eSpark-Backup/noelmcdermott-dbsdesign-hw/Design-Files/DBS-Stepper-Module/Queries/Q-1-1.png

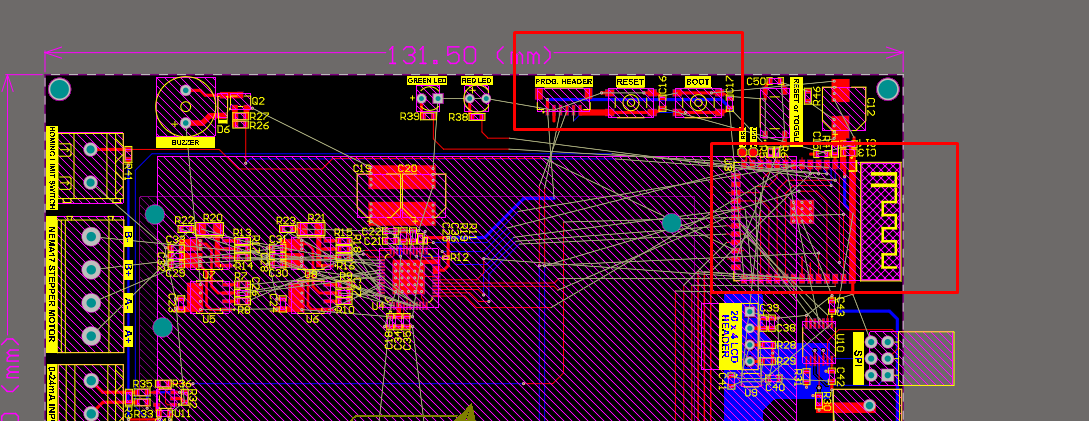
Design-Files/DBS-Stepper-Module/Queries/Q-1-1.png
