eSpark-Backup/noelmcdermott-dbsdesign-hw/Design-Files/DBS-Stepper-Module/Renderings/3D_Top.PNG

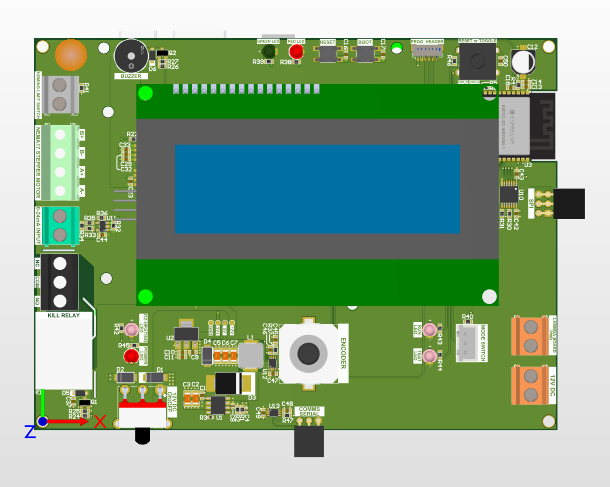
Design-Files/DBS-Stepper-Module/Renderings/3D_Top.PNG
