eSpark-Backup/noelmcdermott-dbsdesign-hw/README.md

# noelmcdermott-dbsdesign-hw
DBS Stepper Control Module

The goal is to drive a Nema17 stepper motor in either direction to a position proportional to a continuously varying 4-24 mA external input or an encoder generated input to a microcontroller. The stepper drives a linear ball screw with a 2mm pitch and “homes” to a limit switch on startup.
