eSpark-Backup/noelmcdermott-dbsdesign-hw/Design-Files/DBS-Stepper-Module/Queries/Q2.png

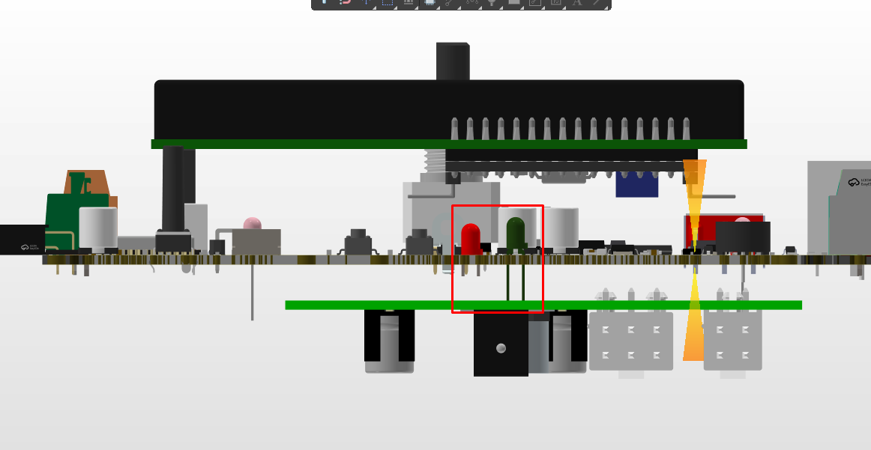
Design-Files/DBS-Stepper-Module/Queries/Q2.png
