eSpark-Backup/noelmcdermott-dbsdesign-hw/Design-Files/DBS-Stepper-Module/Renderings/2D_C_View.PNG

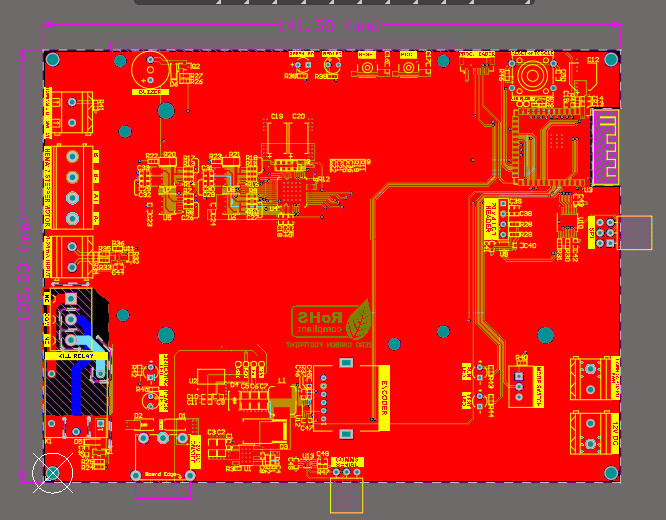
Design-Files/DBS-Stepper-Module/Renderings/2D_C_View.PNG
