eSpark-Backup/noelmcdermott-dbsdesign-hw/Design-Files/DBS-Stepper-Module/Renderings/2D_Top_Layer.PNG

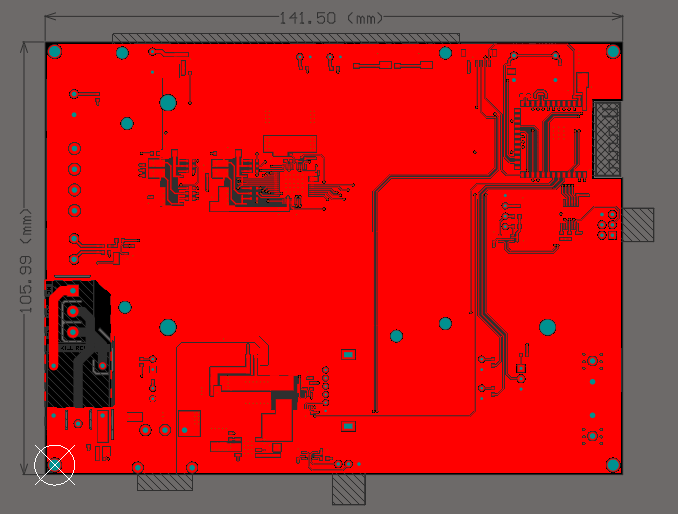
Design-Files/DBS-Stepper-Module/Renderings/2D_Top_Layer.PNG
