eSpark-Backup/noelmcdermott-dbsdesign-hw/Design-Files/DBS-Stepper-Module/Renderings/3D_Back_Edge.PNG

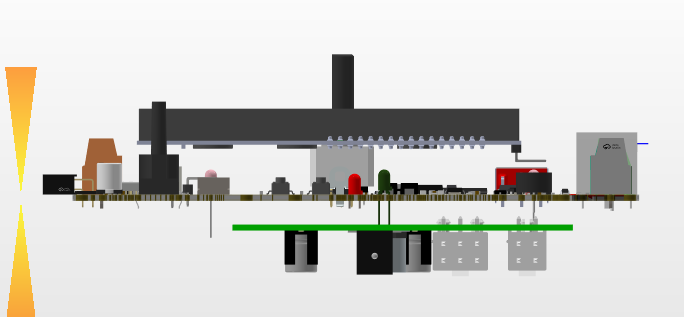
Design-Files/DBS-Stepper-Module/Renderings/3D_Back_Edge.PNG
