eSpark-Backup/noelmcdermott-dbsdesign-hw/Design-Files/DBS-Stepper-Module/Renderings/3D_Combine_View.jpeg

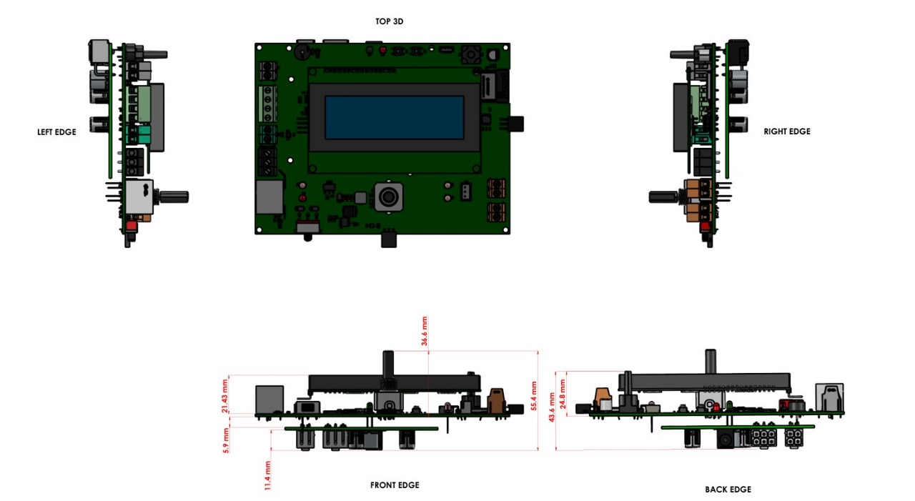
Design-Files/DBS-Stepper-Module/Renderings/3D_Combine_View.jpeg
