eSpark-Backup/noelmcdermott-dbsdesign-hw/Design-Files/DBS-Stepper-Module/Renderings/3D_Isometric.PNG

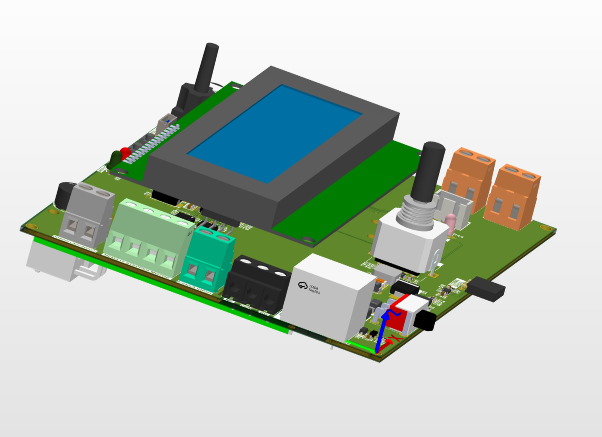
Design-Files/DBS-Stepper-Module/Renderings/3D_Isometric.PNG
