eSpark-Backup/noelmcdermott-dbsdesign-hw/Design-Files/DBS-Stepper-Module/BOM/Client BOM-v1.0.xlsx

# | Item Type | Designator | Description | Footprint | Manufacturer Part Number | Manufacturer | Value | Quantity | Client Ordered Quantity | Link | Remarks
1 | Capacitor | C1, C14, C16, C17, C18, C21, C22, C37, C39, C40, C41, C42, C43, C44, C45, C46, C47, C48, C49, C50 | CAP CER 0.1UF 50V X5R 0603 | Cap-0603 | CC0603KRX5R9BB104 | Yageo | 100nF | 20 | 22
2 | Capacitors | C2, C3 | CAP CER 10UF 50V X5R 1206 | Cap-1206 | CC1206KKX5R9BB106 | Yageo | 10uF | 2 | 4
3 | Capacitors | C4 | CAP CER 390PF 50V C0G 0402 | Cap-0402 | CGA2B2C0G1H391J050BA | TDK | 390pF | 1 | 3
4 | Capacitor | C5, C6, C7 | CAP CER 47UF 25V X5R 1206 | Cap-1206 | GRM31CR61E476ME44L | Murata | 47uF | 3 | 5
5 | Capacitor | C8 | CAP CER 0.047UF 50V X7R 0402 | Cap-0402 | CC0402KRX7R9BB473 | Yageo | 47nF | 1 | 3
6 | Capacitor | C9, C10, C15 | CAP CER 1UF 50V X5R 0603 | Cap-0603 | CL10A105KB8NNNC | Samsung | 1uF | 3 | 5
7 | Capacitor | C11 | CAP CER 4.7UF 16V X5R 0603 | Cap-0603 | CC0603KRX5R7BB475 | Yageo | 4.7uF | 1 | 3
8 | Capacitor | C12 | 47uF 50V 66mA@120Hz ±20% SMD,D6.3xL7.7mm Aluminum Electrolytic Capacitors - SMD ROHS | Custom | RVT1H470M0607 | ROQANG | 47uF | 1 | 3
9 | Capacitor | C13, C38 | CAP CER 22UF 10V X5R 0603 | Cap-0603 | CC0603MRX5R6BB226 | Yageo | 22uF | 2 | 4
10 | Capacitor | C19, C20 | CAP TANT 100UF 20% 25V 2917 | Case-E | TAJE107M025RNJ | Kyocera AVX | 100uF | 2 | 4
11 | Capacitor | C23, C24 | CAP CER 0.47 uF, 50 V, ± 10%, X7R, 0603 [1608 Metric] | Cap-0603 | CC0603KRX7R9BB474 | Yageo | 470nF | 2 | 4
12 | Capacitor | C25 | CAP CER 0.022UF 50V X7R 0603 | Cap-0603 | CC0603KRX7R9BB223 | Yageo | 22nF | 1 | 3
13 | Capacitor | C26, C27, C29, C30 | CAP CER 0.22 uF, 50 V, ± 10%, X7R, 0603 [1608 Metric] | Cap-0603 | CC0603KRX7R9BB224 | Yageo | 220nF | 4 | 6
14 | Capacitor | C28, C31, C32, C33 | CAP CER 1nF 100V X7R 0603 | Cap-0603 | CL10B102KC8NNNC | Samsung | 1nF | 4 | 6
15 | Capacitor | C34, C35 | CAP CER 2.2UF 25V X5R 0603 | CAP-0603 | CC0603KRX5R8BB225 | Yageo | 2.2uF | 2 | 4
16 | Capacitor | C36 | CAP CER 0.47UF 50V X5R 0603 | Cap-0603 | CC0603KRX5R9BB474 | Yageo | 0.47uF | 1 | 3
17 | Diode | D1 | DIODE SCHOTTKY 60V 5A SMA | SMA | SS56 | MDD | - | 1 | 2
18 | (TVS/ESD) | D2 | 20.1A 19.9V 13.3V 12V SMA(DO-214AC) Electrostatic and Surge Protection (TVS/ESD) ROHS | SMA Bi Directional | SMAJ12CA | MDD | - | 1 | 2
19 | Diode | D3 | DIODE SCHOTTKY 40V 5A SMC | SMC | B540C-13-F | Diodes | - | 1 | 2
20 | C693487 | D4 | TVS DIODE 5VWM 9.2VC SMA | SMA Bi Directional | SMAJ5.0CA | FTR | - | 1 | 2
21 | Diode | D5, D6 | DIODE GEN PURP 100V 300MA SOD123 | SOD-123 | 1N4148W-7-F | Diodes | - | 2 | 3
22 | Connector | J1 | 1x6P SH 1 1mm 6 SMD,P=1mm Wire To Board / Wire To Wire Connector ROHS | Custom | C145963 | BOOMELE | - | 1 | 1
23 | Terminal Block | J2 | 1x3P 18A -40℃~+105℃ 250V Black 12~30 Straight pin 5.08mm 2.5 1 3 Plugin,P=5.08mm Screw terminal ROHS | Custom | DB128L-5.08-3P-BK-S | DIBO | - | 1 | 1
24 | Header | J3 | Gold Right-Angle 4P 2.54mm Plugin 1x4P Push-Pull,P=2.54mm Pin Headers ROHS | Custom | PZ2.54-1*4-WZ | ZHOURI | - | 1 | 1
25 | Female Header | J4 | 2.54mm 2.54mm 双排 3A Copper Alloy 6P -40℃~+105℃ 260℃@5S Right-Angle 2x3P side 8.5mm Square Holes Push-Pull,P=2.54mm Female Headers ROHS | HDR 2x3 right angle Female (2.54mm) | PM254-2-03-W-8.5 | HCTL | - | 1 | 1
26 | JST Connector | J5 | CONN HEADER VERT 3POS 2.5MM | Custom | B3B-XH-A(LF)(SN) | JST | - | 1 | 1
27 | Terminal Block | J6 | 1x2P 18A -40℃~+105℃ 250V Green 12~30 Straight 5.08mm 2.5 1 2 Plugin,P=5.08mm Screw terminal ROHS | Custom | DB128L-5.08-2P-GN-S | DORABO | - | 1 | 1
28 | Terminal Block | J7, J11 | 1x2P 18A -40℃~+105℃ 250V Orange 12~30 Straight 5.08mm 2.5 1 2 Plugin,P=5.08mm Screw terminal ROHS | Custom | DB128L-5.08-2P-OG-S | DORABO | - | 2 | 2
29 | Screw terminal | J8 | 1x4P 20A -40℃~+105℃ 300V Green 12~30 Straight 5.08mm 2.5 1 4 Plugin,P=5.08mm Screw terminal ROHS | Custom | DB128V-5.08-4P-GN-S | DORABO | - | 1 | 1
30 | Terminal Block | J9 | 1x2P 20A -40℃~+105℃ 300V Gray 12~30 Straight 5.08mm 1~2.5 1 2 Plugin,P=5.08mm Screw terminal ROHS | Custom | DB128L-5.08-2P-GY-S | DORABO | - | 1 | 1
31 | Female Header | J10 | 2.54mm Plugin 3A Copper Alloy 3P -40℃~+105℃ 260℃@5S Right-Angle 1x3P side 8.5mm Square Holes Push-Pull,P=2.54mm Female Headers ROHS | HDR 1x3 Female Right angle (2.54mm) | PM254-1-03-W-8.5 | HCTL | - | 1 | 1
32 | Relay | K1 | 12V SPDT (1 Form C) Plugin,15.2x19mm Power Relays ROHS | Custom | HF3FA/012-ZSTF(136)(257) | Hongfa | - | 1 | 1
33 | Inductor | L1 | 5.5A 5.6uH Molding Choke ±20% 6.5A SMD,6.6x7mm Power Inductors ROHS | Custom | FXL0630-5R6-M | cjiang | 5.6uH | 1 | 2
34 | LED | LED1, LED6 | 620nm~630nm -30℃~+85℃ Red 30° 200mW Plugin,D=3mm Light Emitting Diodes (LED) ROHS | TH LED Red 3MM | NFD3401URD | Foshan NationStar Optoelectronics | - | 2 | 3
35 | LED | LED2, LED4 | 515nm~525nm -30℃~+85℃ Emerald 30° 200mW Plugin,D=3mm Light Emitting Diodes (LED) ROHS | TH LED 3mm_ | NFD3401UGD | Foshan NationStar Optoelectronics | - | 2 | 3
36 | LED | LED3, LED5 | 20mA -40℃~+80℃ 605nm Amber Color 50° 3mm圆形灯头 75mW Plugin,D=3mm Light Emitting Diodes (LED) ROHS | TH LED 3mm_ | LTL17KFL5D-012A | Lite-On | - | 2 | 3
37 | Buzzers | LS1 | 80dB Active (driven circuit included) Magnetic 2.7kHz Plugin,D=9mm Buzzers ROHS | Custom | FMB09A12-12V | FUET | - | 1 | 1
38 | Test Point | P1, P2, P3, P4 | Test Point ON | Custom |  |  | - | 4 | 0
39 | Mosfet | Q1, Q2 | TRANS NPN 40V 0.6A SMD SOT23-3 | SOT-23 | MMBT2222A-7-F | Diodes | - | 2 | 3
40 |  | R1 | RES SMD 68K OHM 0.1% 1/10W 0603 | Res-0603 | RT0603BRD0768KL | Yageo | 68K | 1 | 2
41 | Resistor | R2 | RES 12K OHM 1% 1/10W 0603 | Res-0603 | RC0603FR-0712KL | Yageo | 12K | 1 | 2
42 | Resistor | R3 | RES SMD 45.3KOHM 0.1% 1/16W 0402 | Res-0402 | RT0402BRD0745K3L | Yageo | 45.3k | 1 | 2
43 | Resistor | R4, R25, R27, R28, R29, R30, R31, R37, R40, R41, R46, R47 | RES SMD 10K Ohm 1% 1/10W 0603 | Res-0603 | RC0603FR-0710KL | Yageo | 10K | 12 | 14
44 | Resistor | R5, R6 | RES 4.7K OHM 1% 1/16W 0402 | Res-0402 | RC0402FR-074K7L | Yageo | 4.7K | 2 | 3
45 | Resistor | R7, R8, R9, R10, R13, R14, R15, R16 | RES 22 OHM 1% 1/10W 0603 | Res-0603 | RC0603FR-0722RL | Yageo | 22R | 8 | 10
46 | Resistor | R11, R12 | RES 47K OHM 1% 1/20W 0201 | Res-0201 | RC0201FR-0747KL | Yageo | 47K | 2 | 3
47 | Resistor | R17, R18, R22, R23 | RES SMD 47OHM 0.1W 0603 | Res-0603 | RC0603FR-0747RL | Yageo | 47R | 4 | 6
48 | Resistor | R19 | RES 2.2 OHM 1% 1/16W 0402 | Res-0402 | RC0402FR-072R2L | Yageo | 2.2R | 1 | 2
49 | Resistor Current Sense | R20, R21 | RES 0.075 OHM 1% 1W 1206 | Res-1206 | ERJ-8BWFR075V | Panasonic | 75mR | 2 | 3
50 | Resistor | R24, R26 | RES 470 OHM 1% 1/10W 0603 | Res-0603 | RC0603FR-07470RL | Yageo | 470R | 2 | 3
51 | Resistor | R32, R33, R35, R36 | RES SMD 100K OHM 0.1% 1/10W 0603 | Res-0603 | RT0603BRD07100KL | Yageo | 100K | 4 | 6
52 | Resistor | R34 | RES SMD 120 OHM 0.1% 1/10W 0603 | Res-0603 | RT0603BRB07120RL | Yageo | 120R | 1 | 2
53 | Resistor | R38, R42, R44 | RES 130 OHM 1% 1/10W 0603 | Res-0603 | RC0603FR-07130RL | Yageo | 130R | 3 | 4
54 | Resistor | R39, R43 | RES 15 OHM 1% 1/10W 0603 | Res-0603 | RC0603FR-0715RL | Yageo | 15R | 2 | 3
55 | Resistor | R45 | RES SMD 1.2K OHM 1% 1/10W 0603 | Res-0603 | RC0603FR-071K2L | Yageo | 1.2K | 1 | 2
56 | Switch | SW1, SW2 | No NO 50mA 4.5mm 100000 260gf 12V -30℃~+85℃ 4.5mm 4.3mm Black Round Button Brick nogging SPST SMD Tactile Switches ROHS | Custom | TS-1109S-C-B | XKB Connectivity | - | 2 | 2
57 | Rotary Encoder | SW3 | ROTARY ENCODER OPTICAL 25PPR | Custom | REC16B25-201-C | Nidec Copal | - | 1 | 1
58 | Slide Switch | SW4 | Shrouded 5A SPDT 125V 6.3mm 13.5mm 125V 6.6mm 5A PCPin 10000 Rectangular columnar -40℃~+85℃ Black Plugin Slide Switches ROHS | Custom | SS-12D11G5R | XKB Connectivity | - | 1 | 1
59 | Switch | SW6 | 10mm 23.2mm Round Button 50mA Straight 10mm SPST 12V Plugin Tactile Switches ROHS | Custom | SKQBAQA010 | Alps Electric | - | 1 | 1
60 | IC | U1 | IC REG BUCK ADJUSTABLE 3A 8SOPWR | 8-SO-EP_ | LMR16030SDDAR | Texas Instruments | - | 1 | 1
61 | IC | U2 | IC REG LINEAR 3.3V 1.2A SOT223 | SOT- 223 | LDL1117S33R | STMicroelectronics | - | 1 | 1
62 | Module | U3 | SMD,18x25.5mm WiFi Modules ROHS | 41-SMD Module | ESP32-S3-WROOM-1-N8R2 | Espressif Systems | - | 1 | 1
63 | IC | U4 | IC MTR DRV BIPOLAR 10-50V 48TQFP | 48-TQFP-EP(7x7) | TMC2160A-TA-T | Trinamic | - | 1 | 1
64 | MOSFET | U5, U6, U7, U8 | MOSFET 2N-CH 60V 9.5A 8SOIC | SOIC-8 | AOSD62666E | Alpha & Omega Semiconductor | - | 4 | 4
65 | IC | U9 | IC TRANSLTR BIDIRECTIONAL 8VSSOP | VSSOP-8(3.1x2.1) | TXS0102DCUR | Texas Instruments | - | 1 | 1
66 | IC | U10 | IC TRANSLATOR UNIDIR 14TSSOP | 14-TSSOP | TXU0304PWR | Texas Instruments | - | 1 | 1
67 | OpAmp | U11 | SOT-23-5 Precision OpAmps ROHS | SOT-23-5 | TP5591-TR | 3PEAK | - | 1 | 1
68 | IC | U12, U13 | IC TRNSLTR BIDIRECTIONAL US8 | Custom | TXB0102DCUT | Texas Instruments | - | 2 | 2
69 | Peripheral | - | Controlduino 01M21V00. Wideband lambda sensor control module for Arduino + rpm. | - | 01M21V00 | Controlduino |  | 1 | 1 | Controlduino (https://controlduino.com/store/Controlduino-01M21V00-Wideband-lambda-sensor-control-module-for-Arduino-rpm-p469875327) | Also Select optional parts 1# OEM : 0258017025. 2# AC/DC Power supply
70 | Peripheral | - | 204 20X4 2004 Parallel IIC I2C PCF8574T Character LCD Module Display Screen LCM English-Japanese w/ LED Backlight for Arduino | - | SLC2004A1-FPW-IIC |  |  | 1 | 1 | Aliexpress (https://vi.aliexpress.com/item/1005005720465455.html?gatewayAdapt=glo2vnm)
