eSpark-Backup/noelmcdermott-dbsdesign-hw/Design-Files/DBS-Stepper-Module/Supporting_Files/PCB_DBS_Module-v1.0.DXF

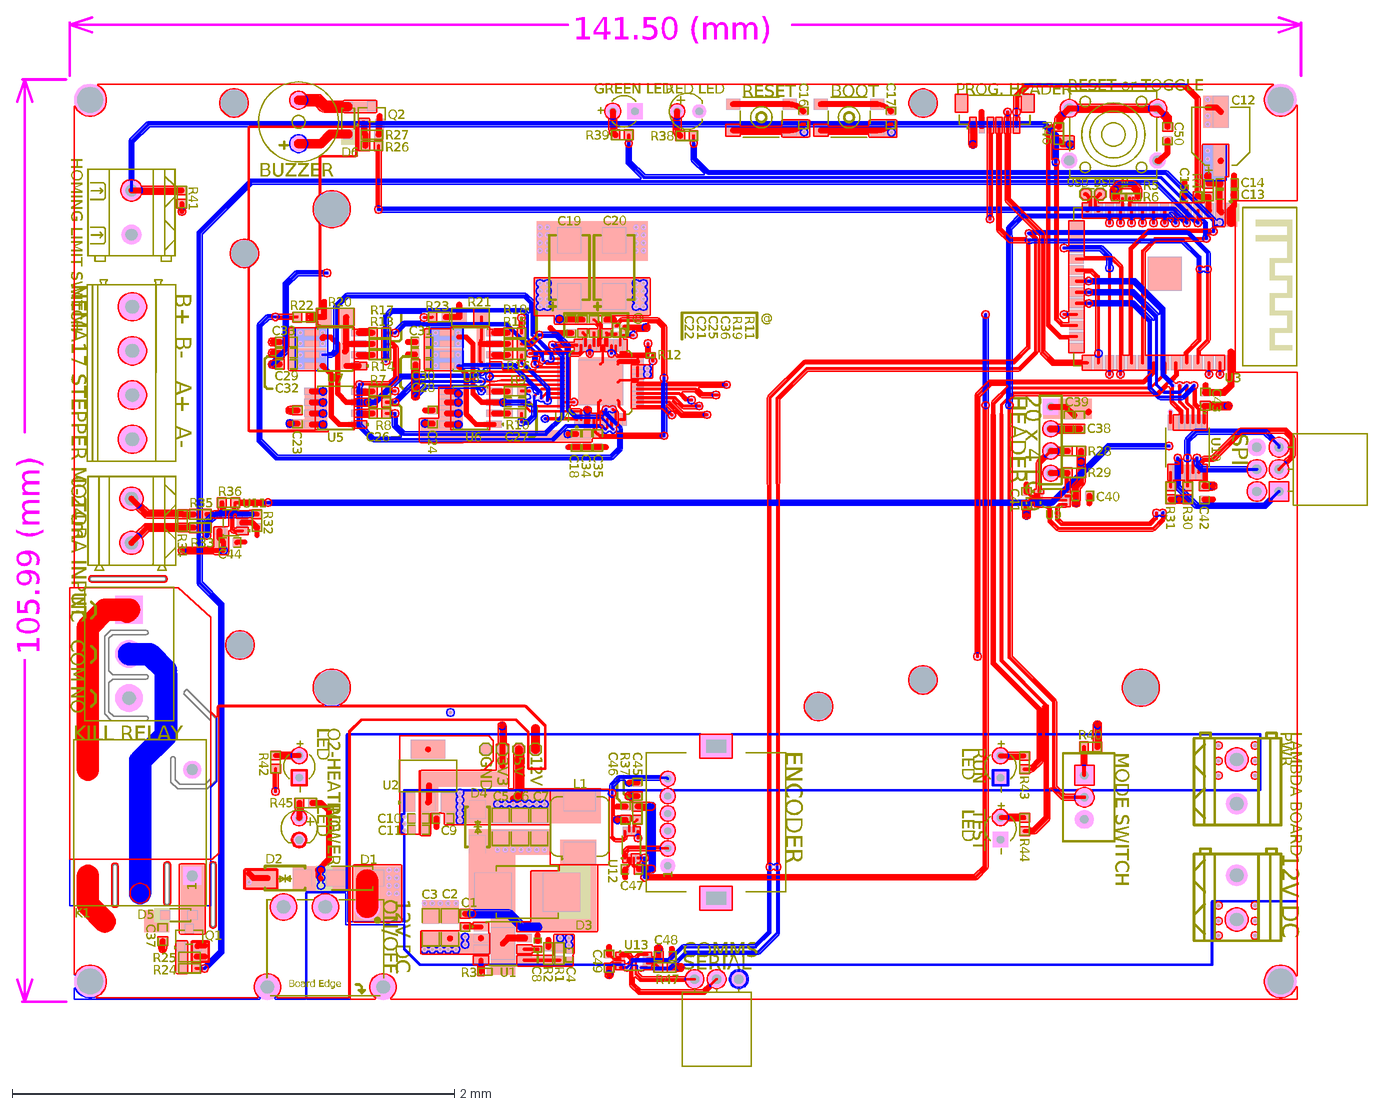
[picture p17: CAD file, 2024-07-20]
Design-Files/DBS-Stepper-Module/Supporting_Files/PCB_DBS_Module-v1.0.DXF
NO
RESET or TOGGLE
ENCODER
12V DC
PWR
LAMBDA BOARD
LED
POWER
MODE SWITCH
HOMING LIMIT SWITCH
KILL RELAY
B+
3V3
RESET
A-
SERIAL
COMMS
HEADER
20 x 4 LCD
NEMA17 STEPPER MOTOR
RUN
COM
0-24mA INPUT
RED LED
A+
GND
GREEN LED
O2-HEATING
USB_P
BOOT
5V
ON/OFF
12V
BUZZER
NC
USB_N
TEST
PROG. HEADER
B-
SPI
@
105.99 (mm)
141.50 (mm)
U8
U13
U12
U11
U10
U9
U7
U6
U5
U4
U3
U2
U1
Board Edge
1
R47
R46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
