eSpark-Backup/noelmcdermott-dbsdesign-hw/(list of files, cad)

Other CAD files:
Design-Files/DBS-Stepper-Module/Supporting_Files/PCB_DBS_Module-v1.0.DWG
