eSpark-Backup/noelmcdermott-dbsdesign-hw/docs/Client-Files/DBS_screw_schematic_18-05-2024.pdf

# DBS_SCREW-SCHEMATIC

18-05-2024

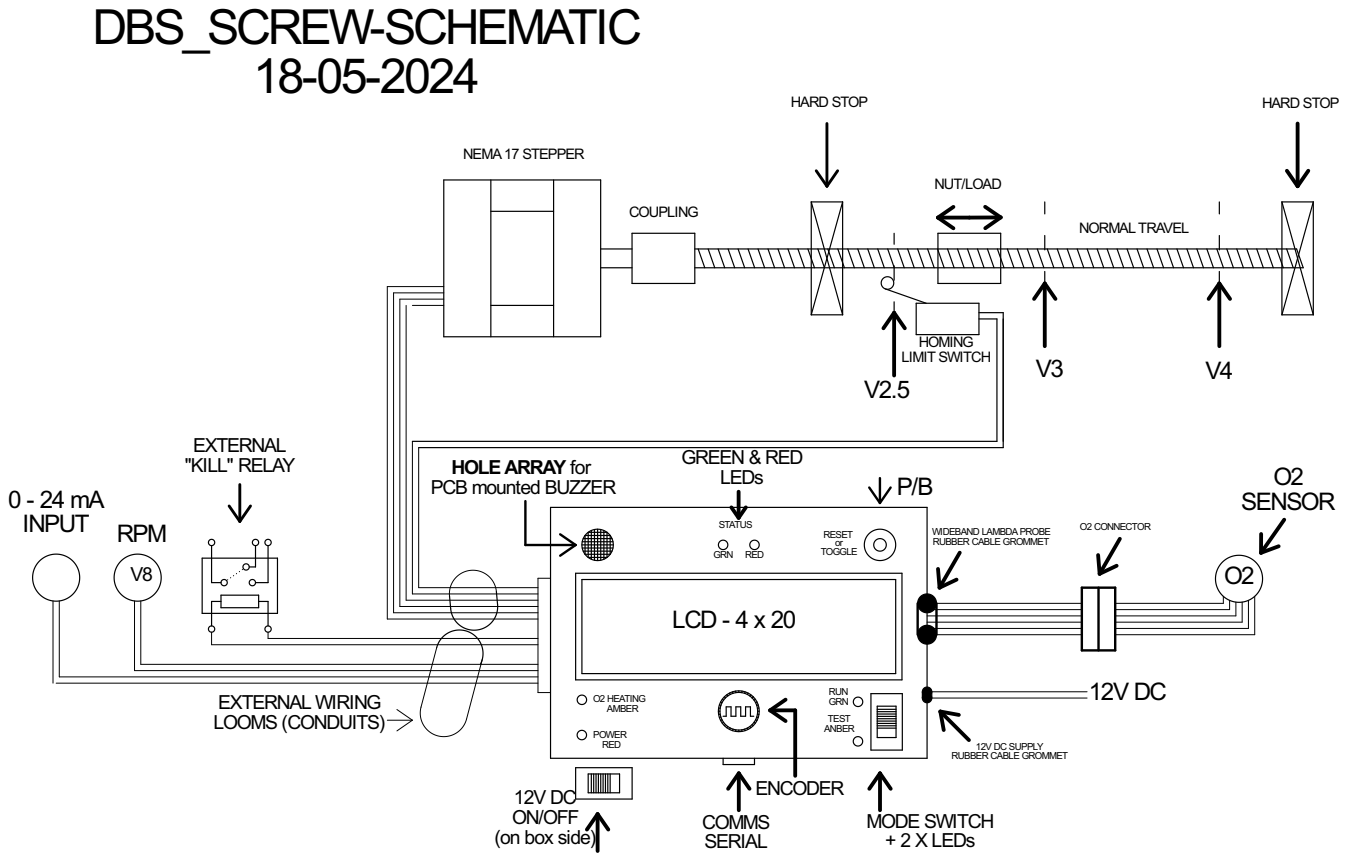
[picture p18: page 1]
NEMA 17 STEPPER; COUPLING; NORMALTRAVEL; HARD STOP; NUT/LOAD; HOMING LIMIT SWITCH; LCD - 4 x 20; COMMS SERIAL; EXTERNAL WIRING LOOMS (CONDUITS); RPM; 0 - 24 mA INPUT; EXTERNAL; "KILL" RELAY; GREEN & RED; LEDs; ENCODER; MODE SWITCH + 2 X LEDs; STATUS; O2 HEATING AMBER; RESET TOGGLE; POWER RED; RUN GRN; GRN RED; TEST ANBER; WIDEBAND LAMBDA PROBE RUBBER CABLE GROMMET; O2 CONNECTOR; O2 SENSOR

HOLE ARRAY for
PCB mounted BUZZER

12V DC SUPPLY RUBBER CABLE GROMMET

ON/OFF
(on box side)
