eSpark-Backup/noelmcdermott-dbsdesign-hw/Design-Files/DBS-Stepper-Module/Schematics/Schematic_DBS-Stepper-Module-v1.0.pdf

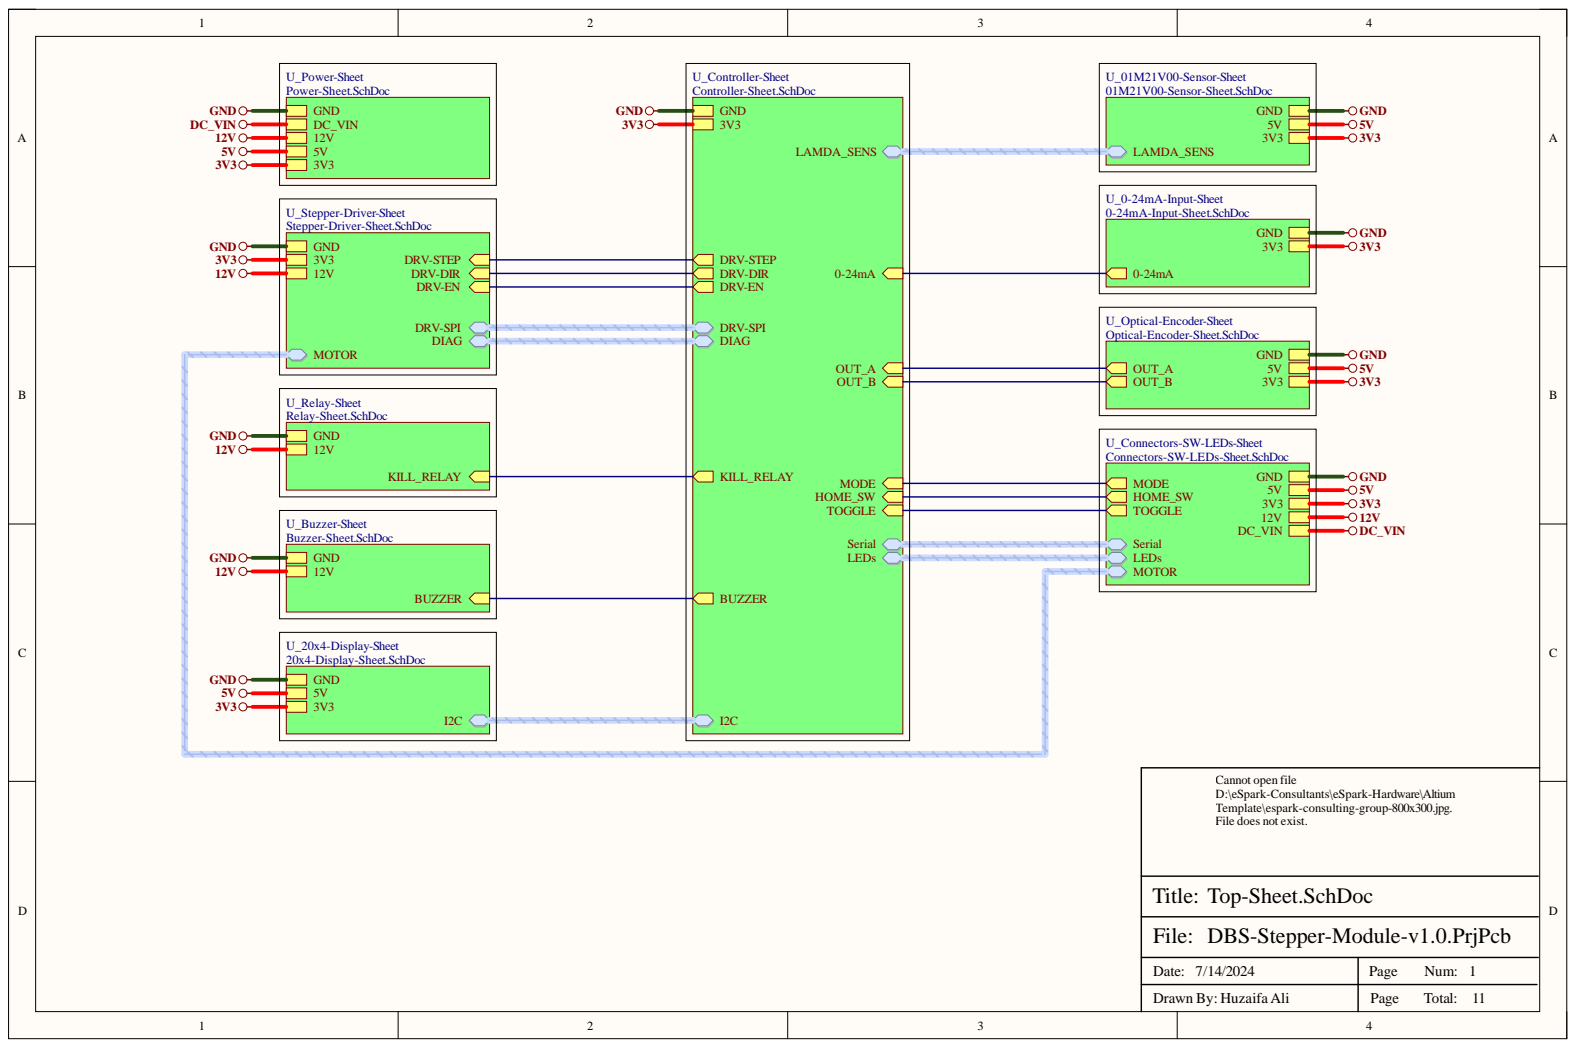
[picture p19: page 1]

U_Optical-Encoder-Sheet
Optical-Encoder-Sheet.SchDoc

U_Connectors-SW-LEDs-Sheet
Connectors-SW-LEDs-Sheet.SchDoc

Cannot open file
D:\eSpark-Consultants\eSpark-Hardware\Altium
Template\espark-consulting-group-800x300.jpg.
File does not exist.

DBS-Stepper-Module-v1.0.PrjPcb

Date: 7/14/2024 | Page Num: 1

Drawn By: Huzaifa Ali | Page Total: 11

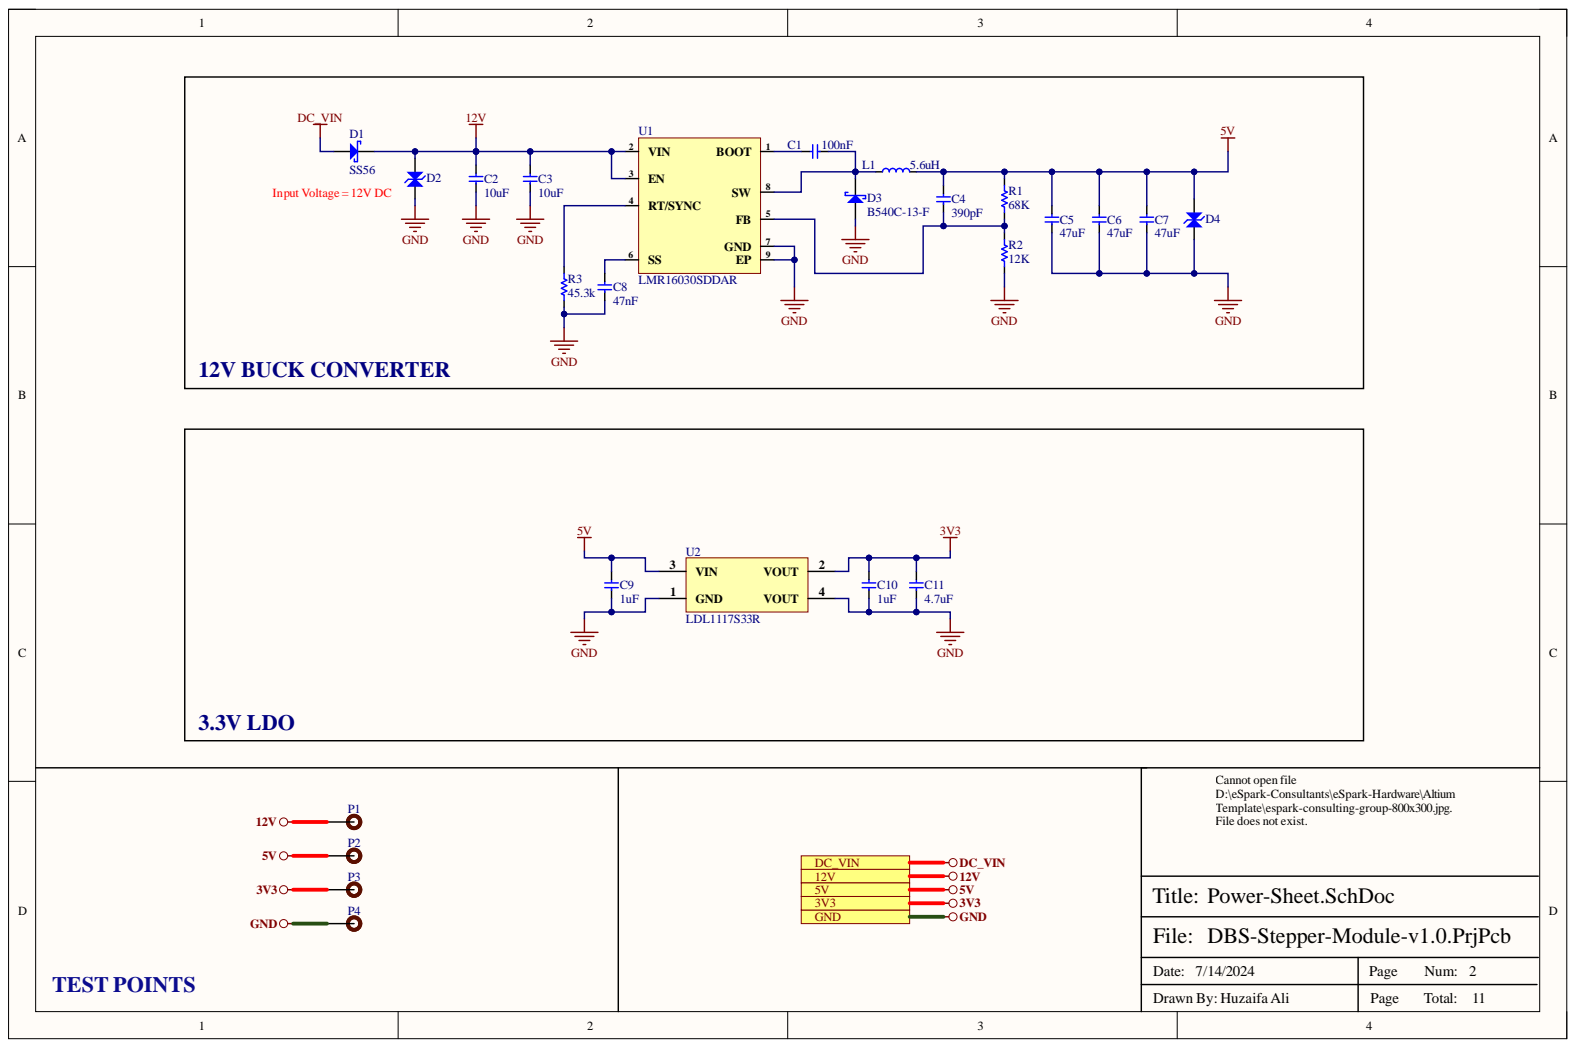
[picture p20: page 2]
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

DBS-Stepper-Module-v1.0.PrjPcb

Date: 7/14/2024 | Page Num: 2

Drawn By: Huzaifa Ali | Page Total: 11

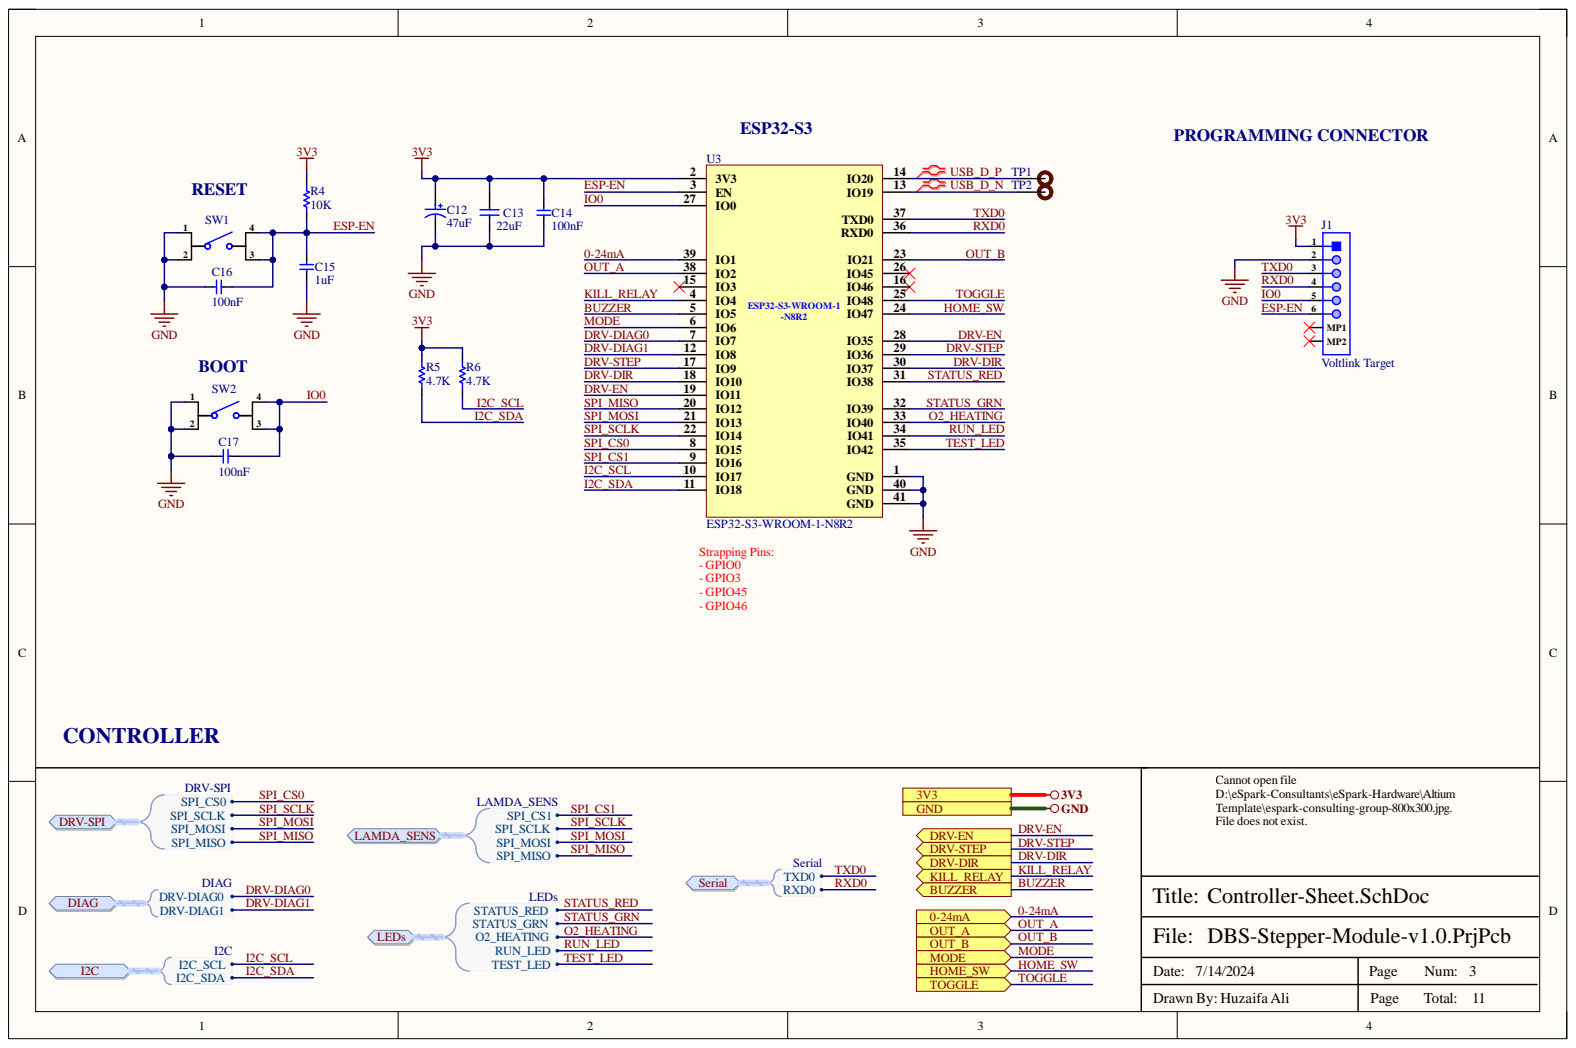
[picture p21: page 3]
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

DBS-Stepper-Module-v1.0.PrjPcb

Date: 7/14/2024 | Page Num: 3

Drawn By: Huzaifa Ali | Page Total: 11

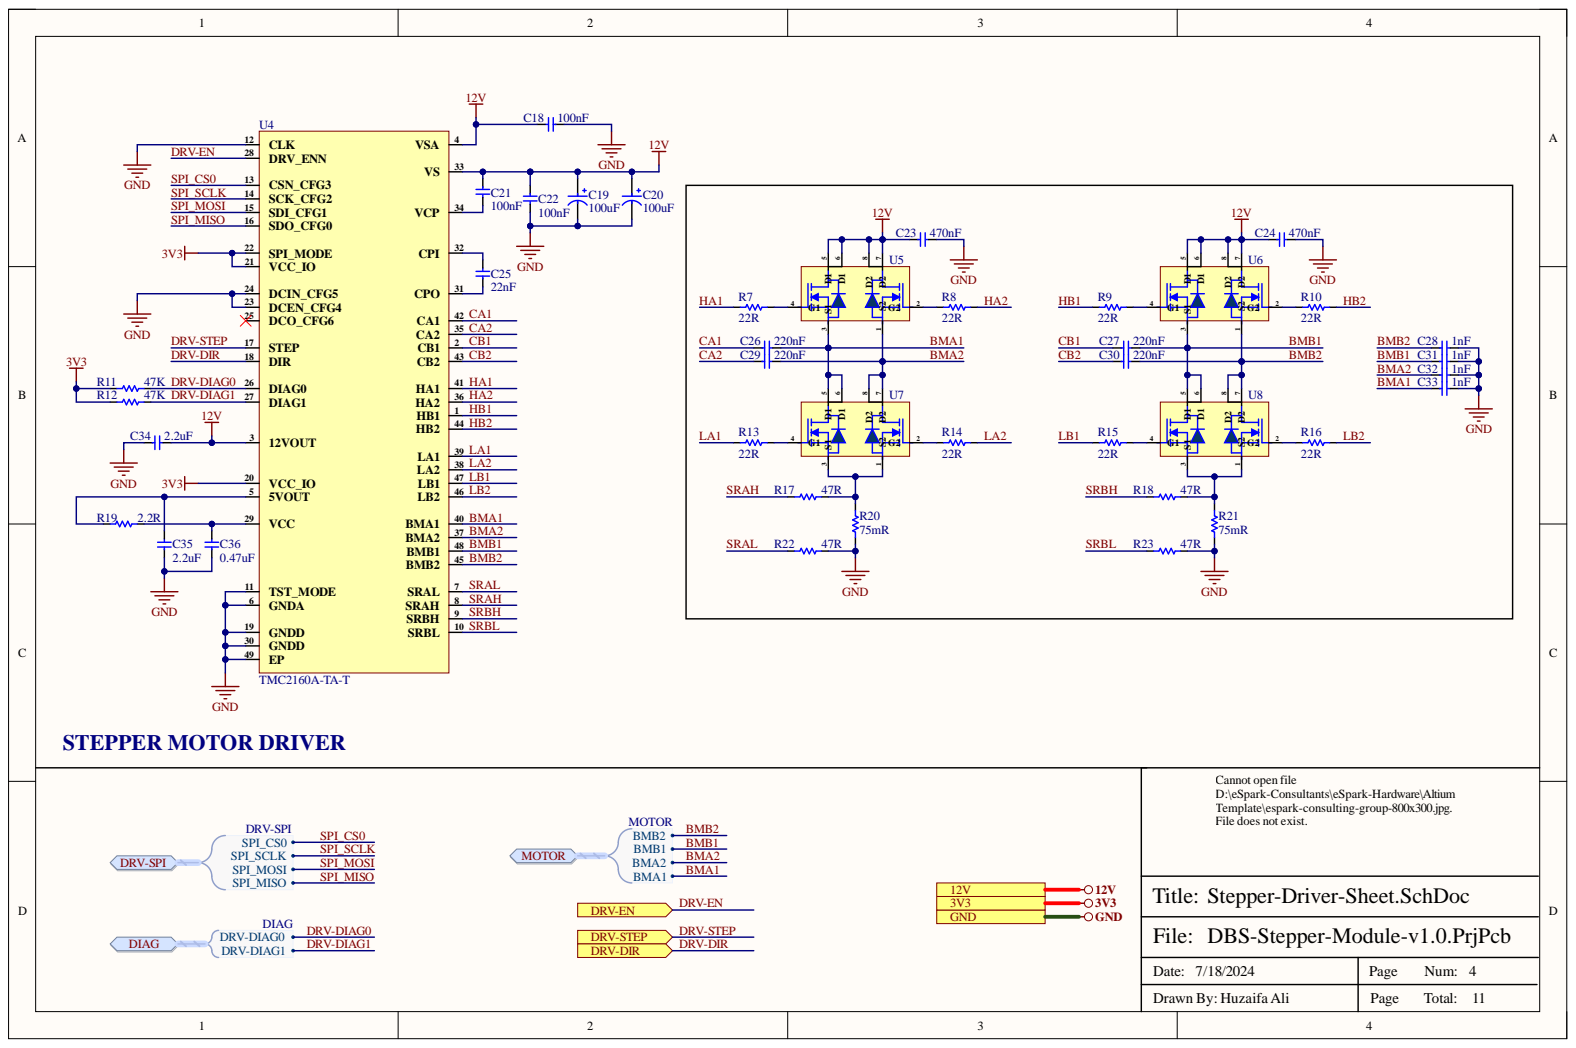
[picture p22: page 4]

R12 | 47K DRV-DIAG1

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

Stepper-Driver-Sheet.SchDoc

DBS-Stepper-Module-v1.0.PrjPcb

Date: 7/18/2024 | Page Num: 4

Drawn By: Huzaifa Ali | Page Total: 11

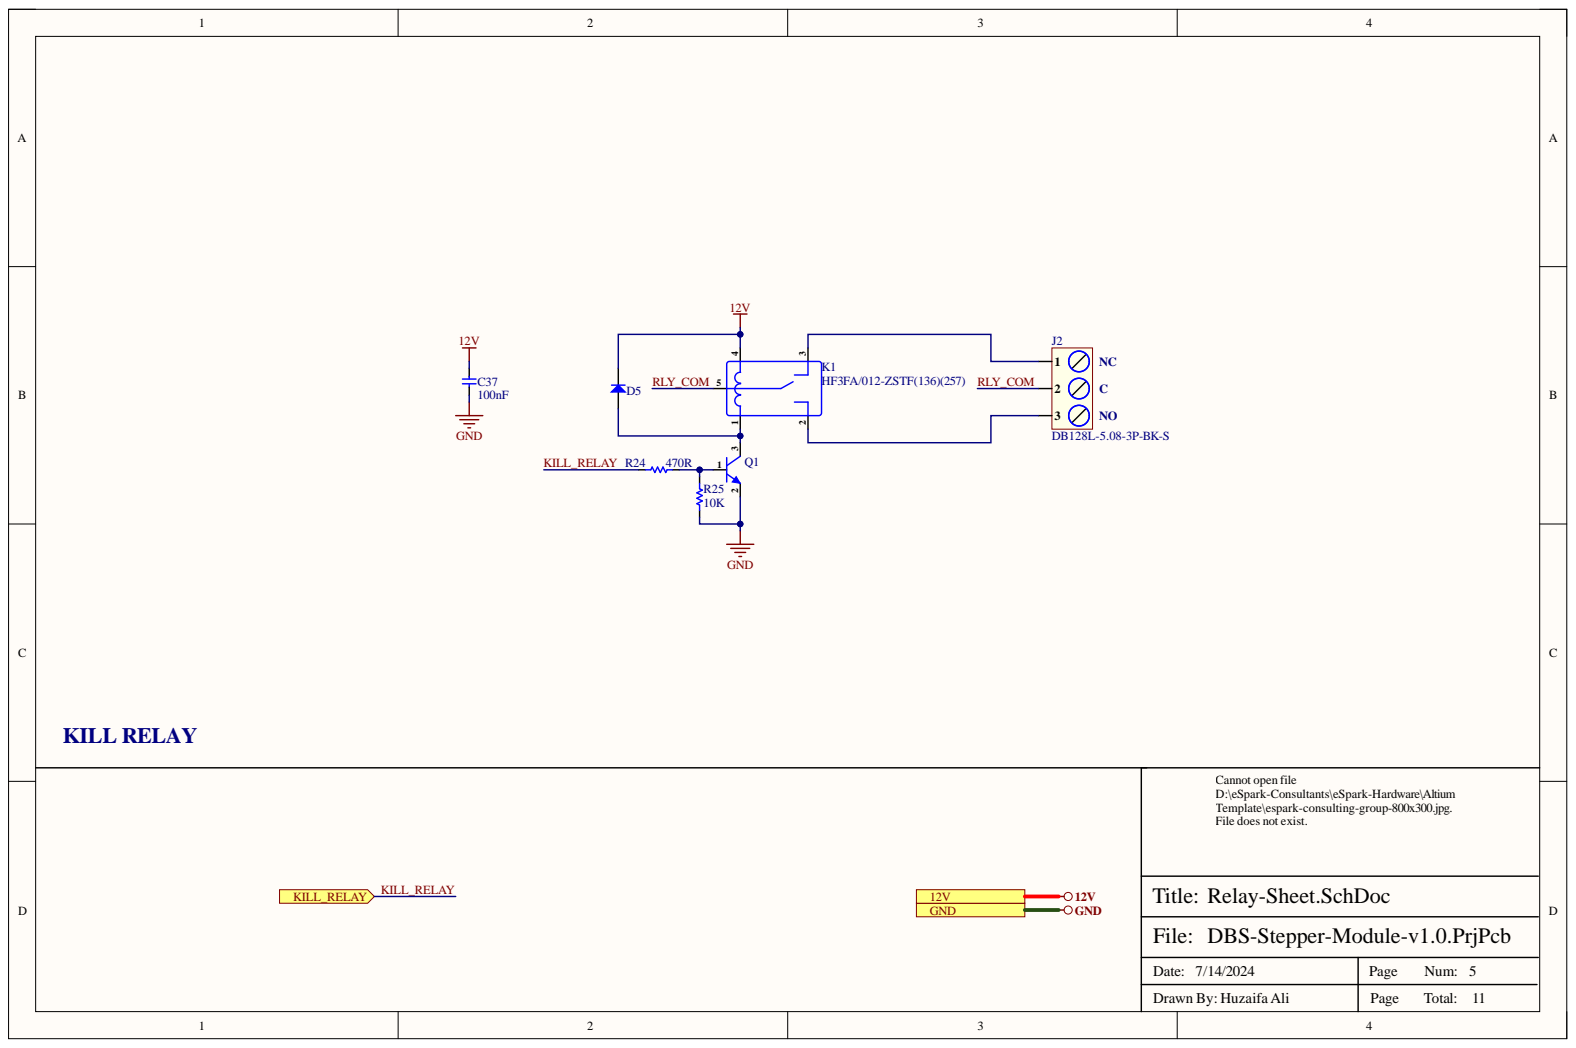
[picture p23: page 5]
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

DBS-Stepper-Module-v1.0.PrjPcb

Date: 7/14/2024 | Page Num: 5

Drawn By: Huzaifa Ali | Page Total: 11

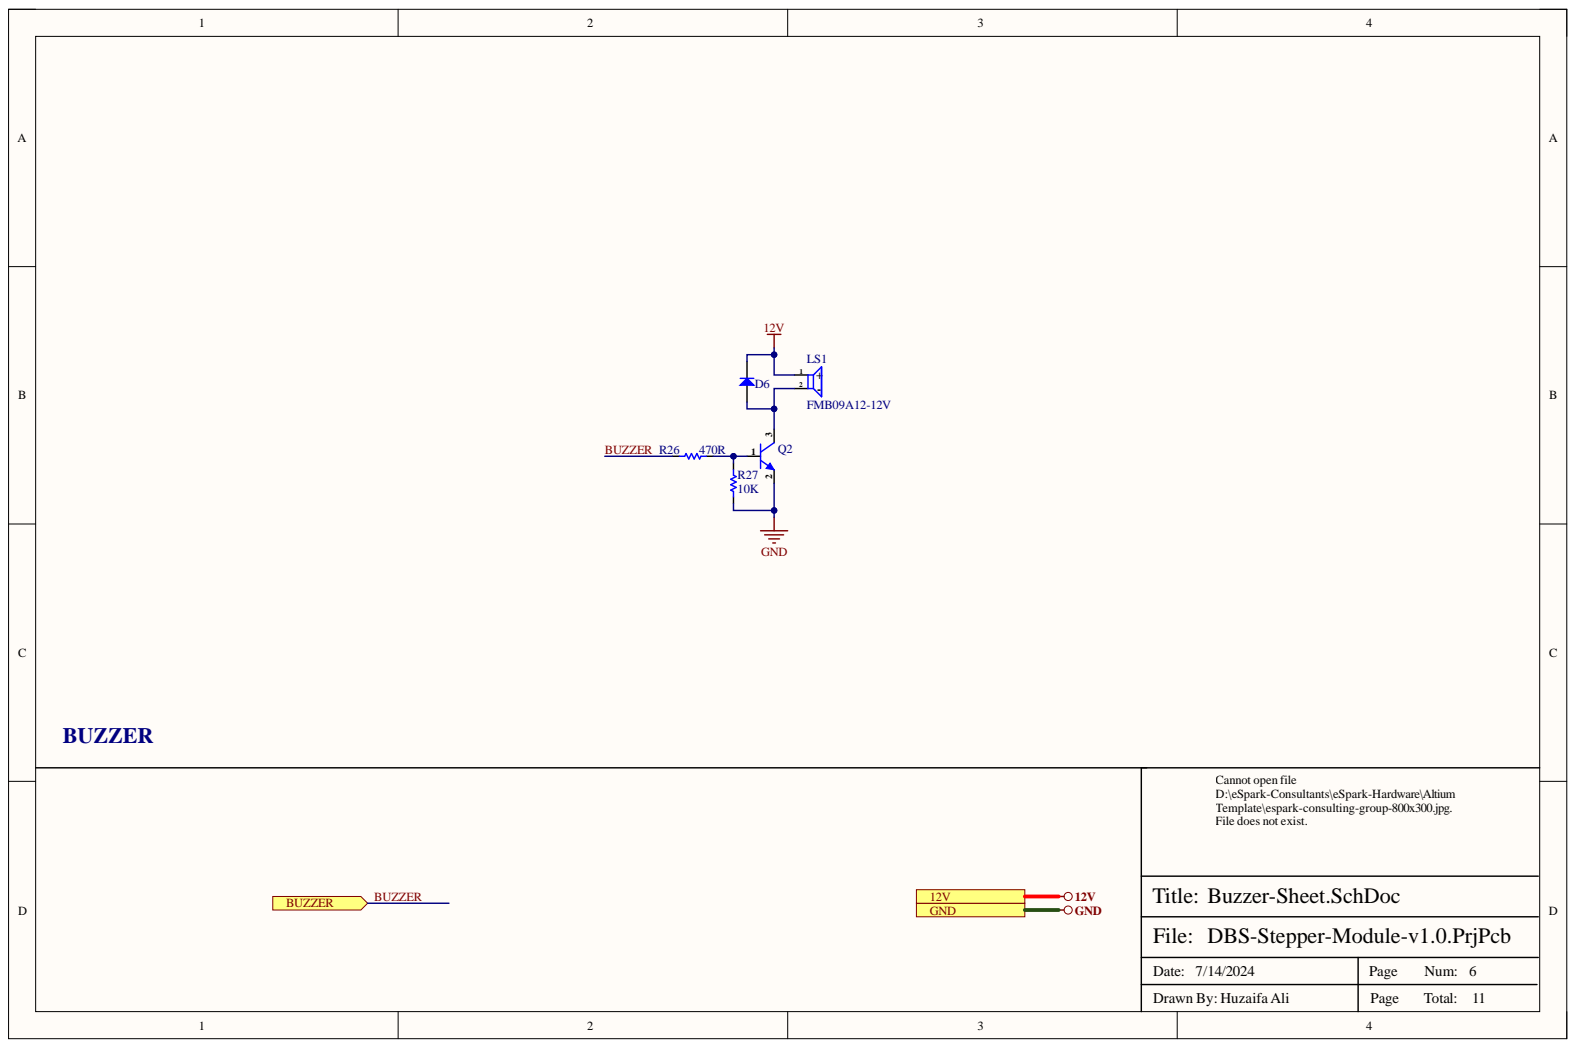
[picture p24: page 6]
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

DBS-Stepper-Module-v1.0.PrjPcb

Date: 7/14/2024 | Page Num: 6

Drawn By: Huzaifa Ali | Page Total: 11

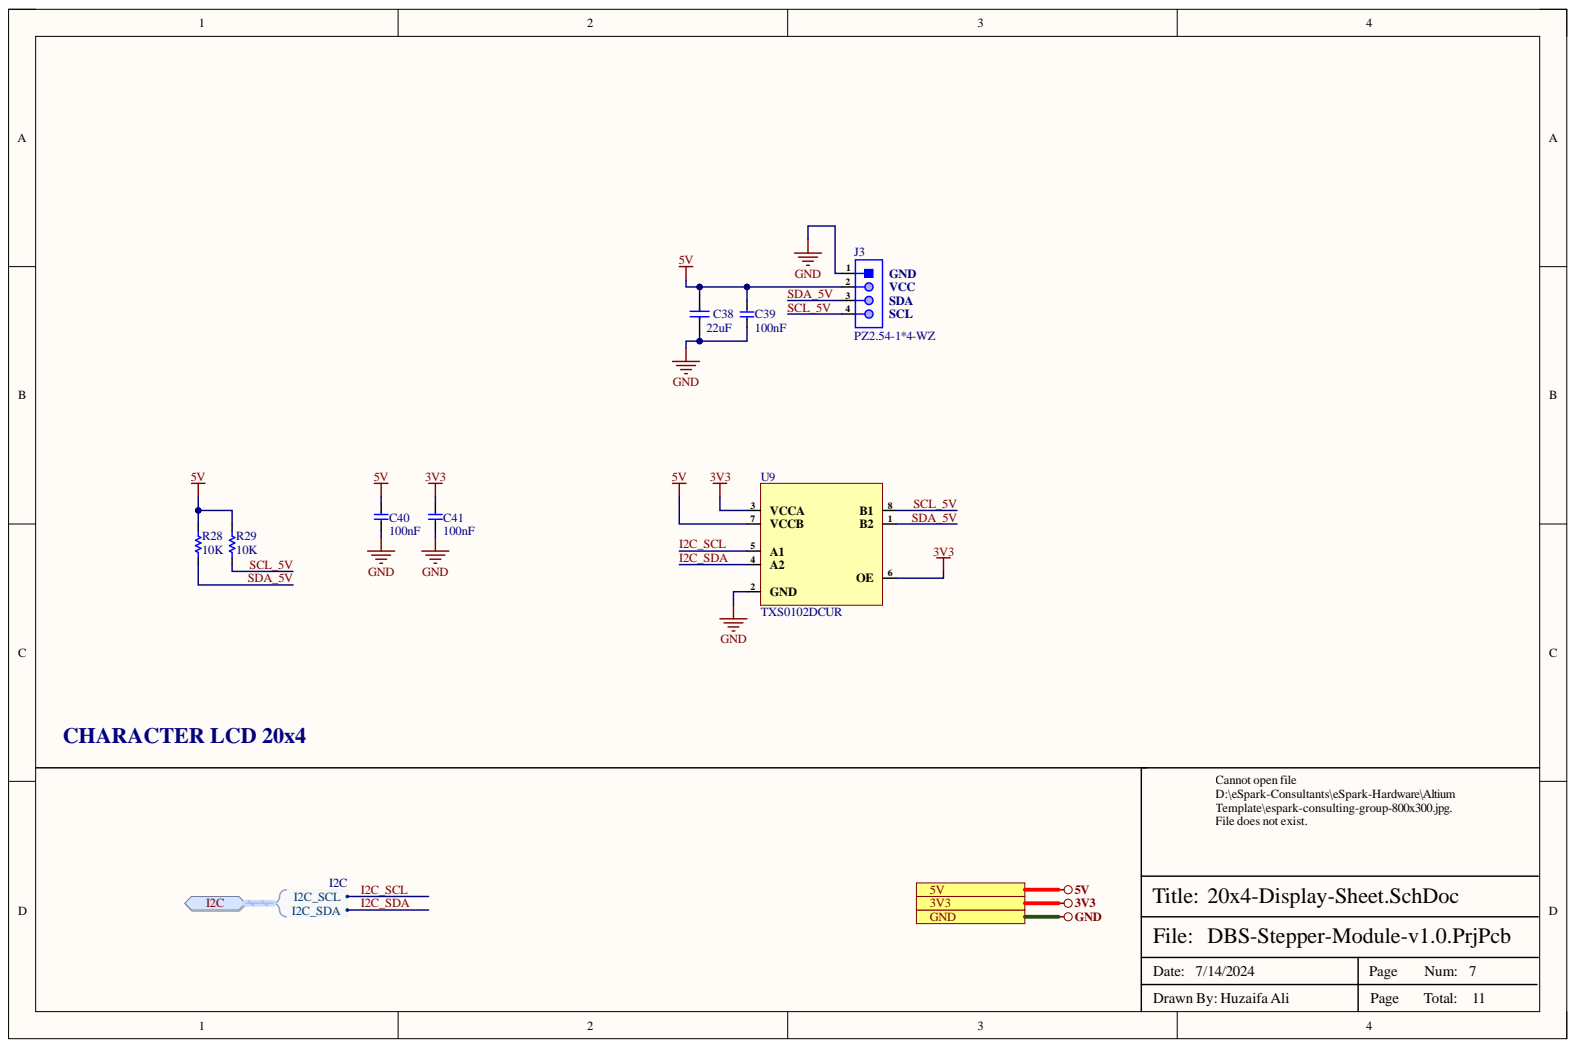
[picture p25: page 7]
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

DBS-Stepper-Module-v1.0.PrjPcb

Date: 7/14/2024 | Page Num: 7

Drawn By: Huzaifa Ali | Page Total: 11

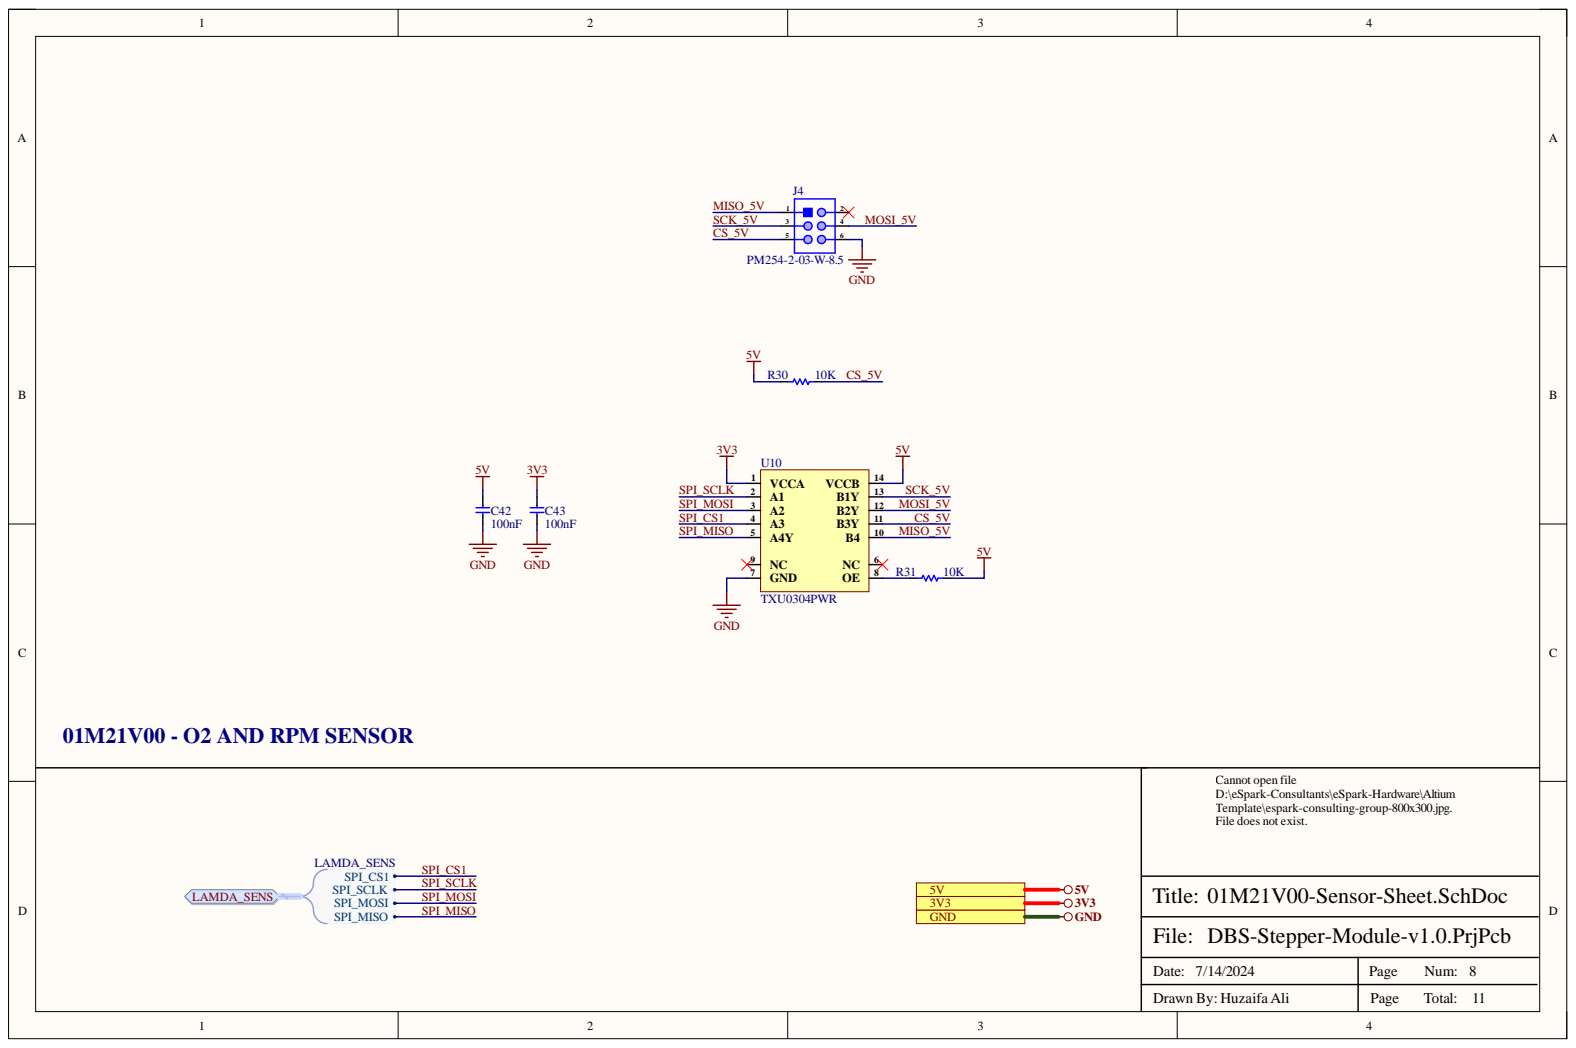
[picture p26: page 8]
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

DBS-Stepper-Module-v1.0.PrjPcb

Date: 7/14/2024 | Page Num: 8

Drawn By: Huzaifa Ali | Page Total: 11

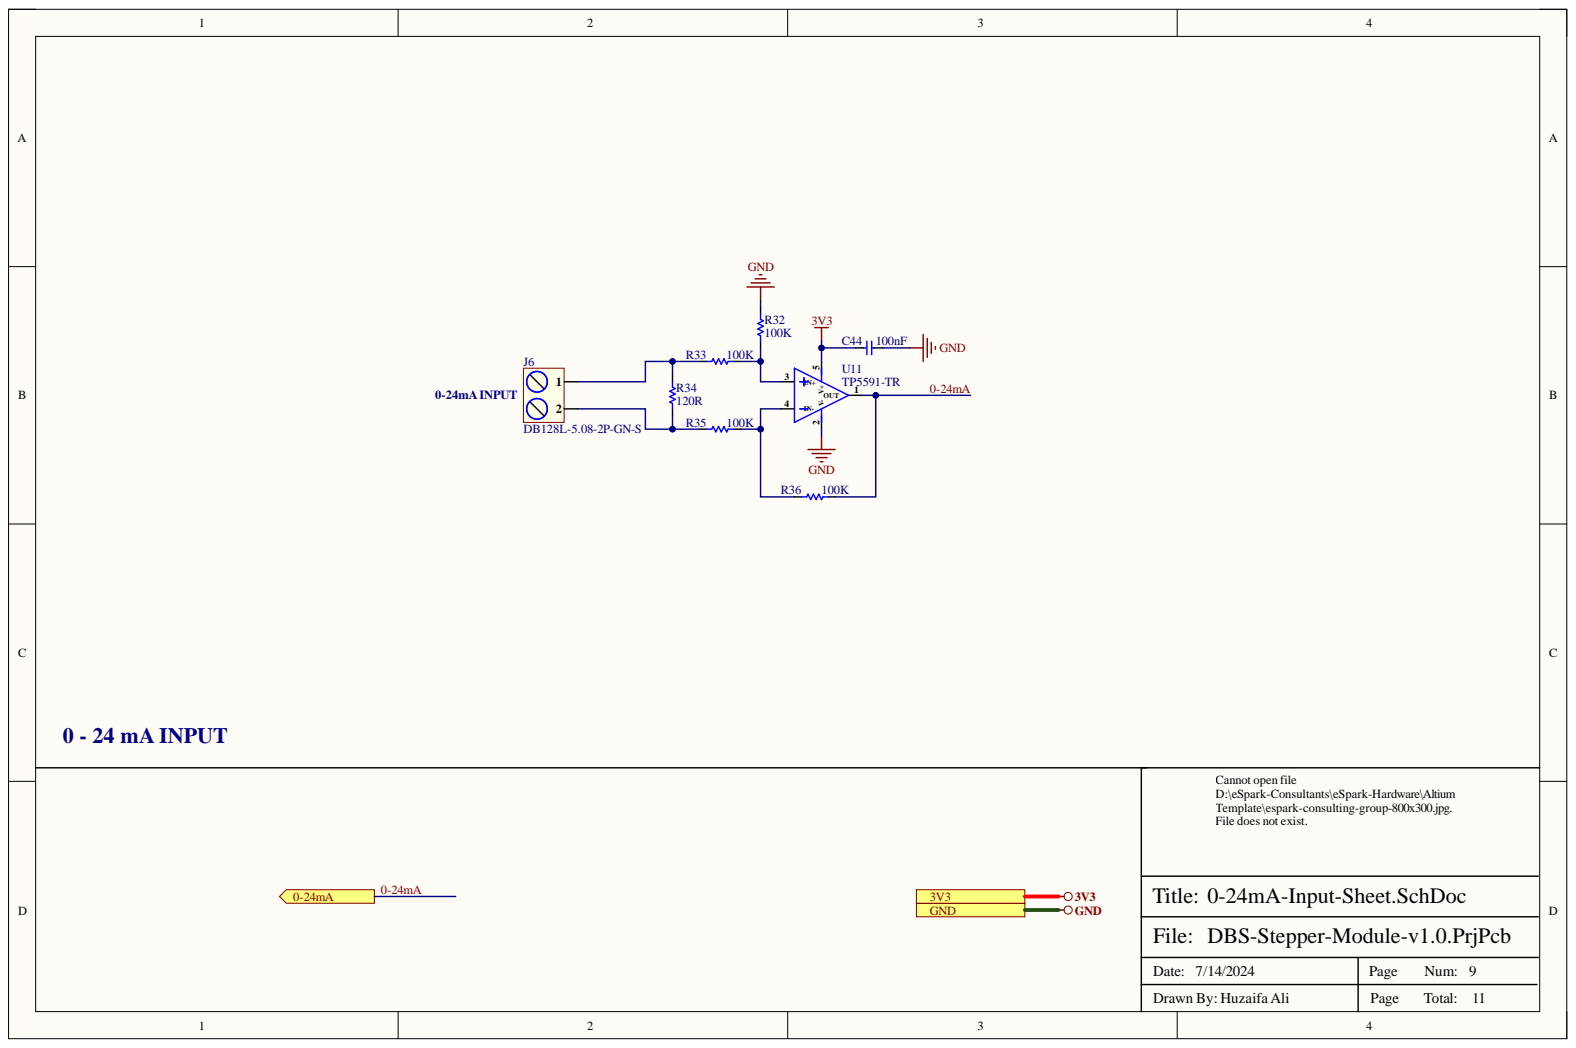
[picture p27: page 9]
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

DBS-Stepper-Module-v1.0.PrjPcb

Date: 7/14/2024 | Page Num: 9

Drawn By: Huzaifa Ali | Page Total: 11

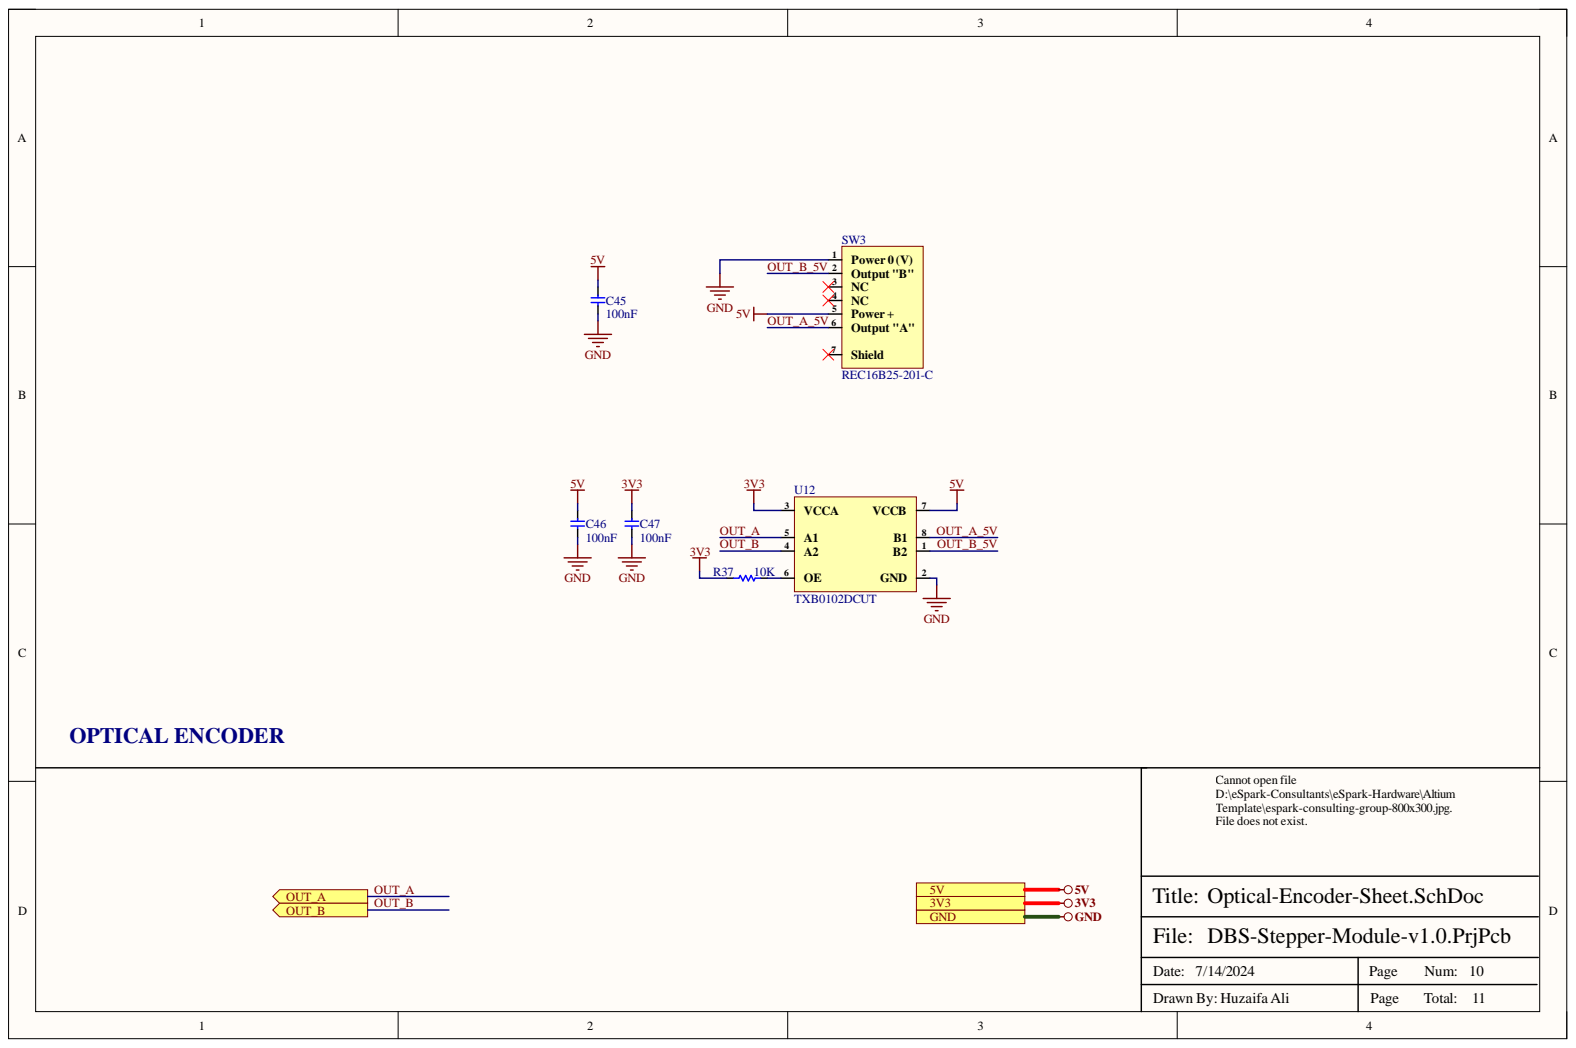
[picture p28: page 10]
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

Optical-Encoder-Sheet.SchDoc

DBS-Stepper-Module-v1.0.PrjPcb

Date: 7/14/2024 | Page Num: 10

Drawn By: Huzaifa Ali | Page Total: 11

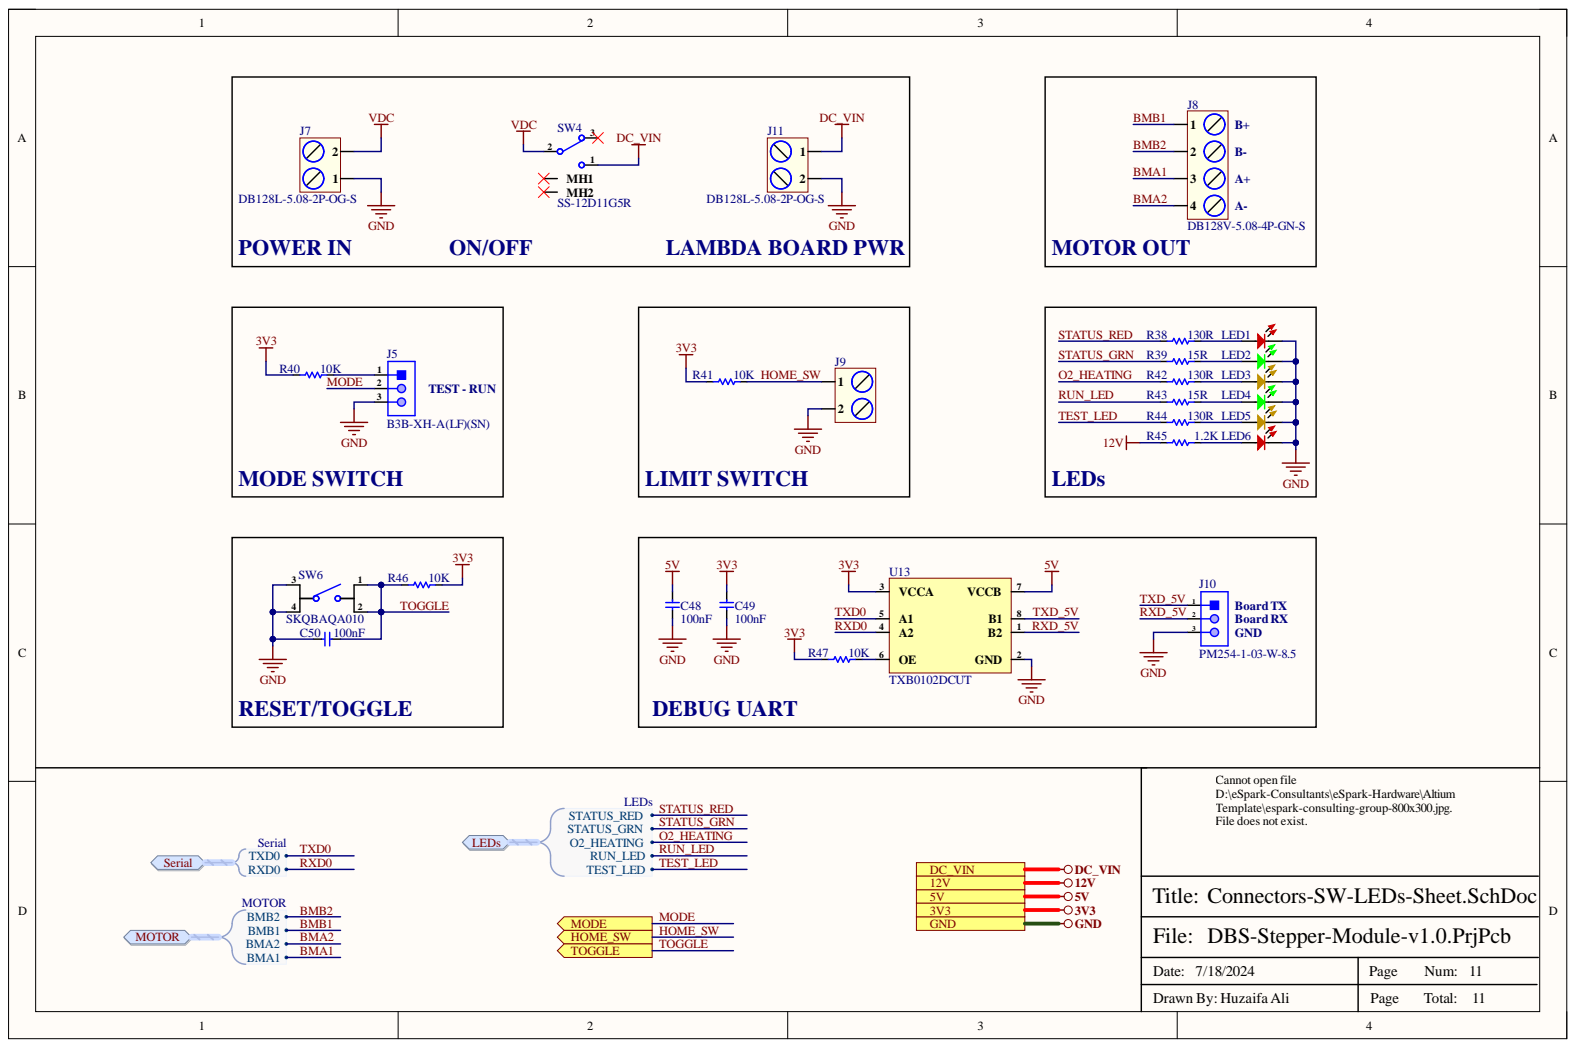
[picture p29: page 11]
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

Connectors-SW-LEDs-Sheet.SchDoc

DBS-Stepper-Module-v1.0.PrjPcb

Date: 7/18/2024 | Page Num: 11

Drawn By: Huzaifa Ali | Page Total: 11
