eSpark-Backup/noelmcdermott-dbsdesign-hw/Design-Files/DBS-Stepper-Module/Schematics/Assembly_Drawings-v1.0.pdf

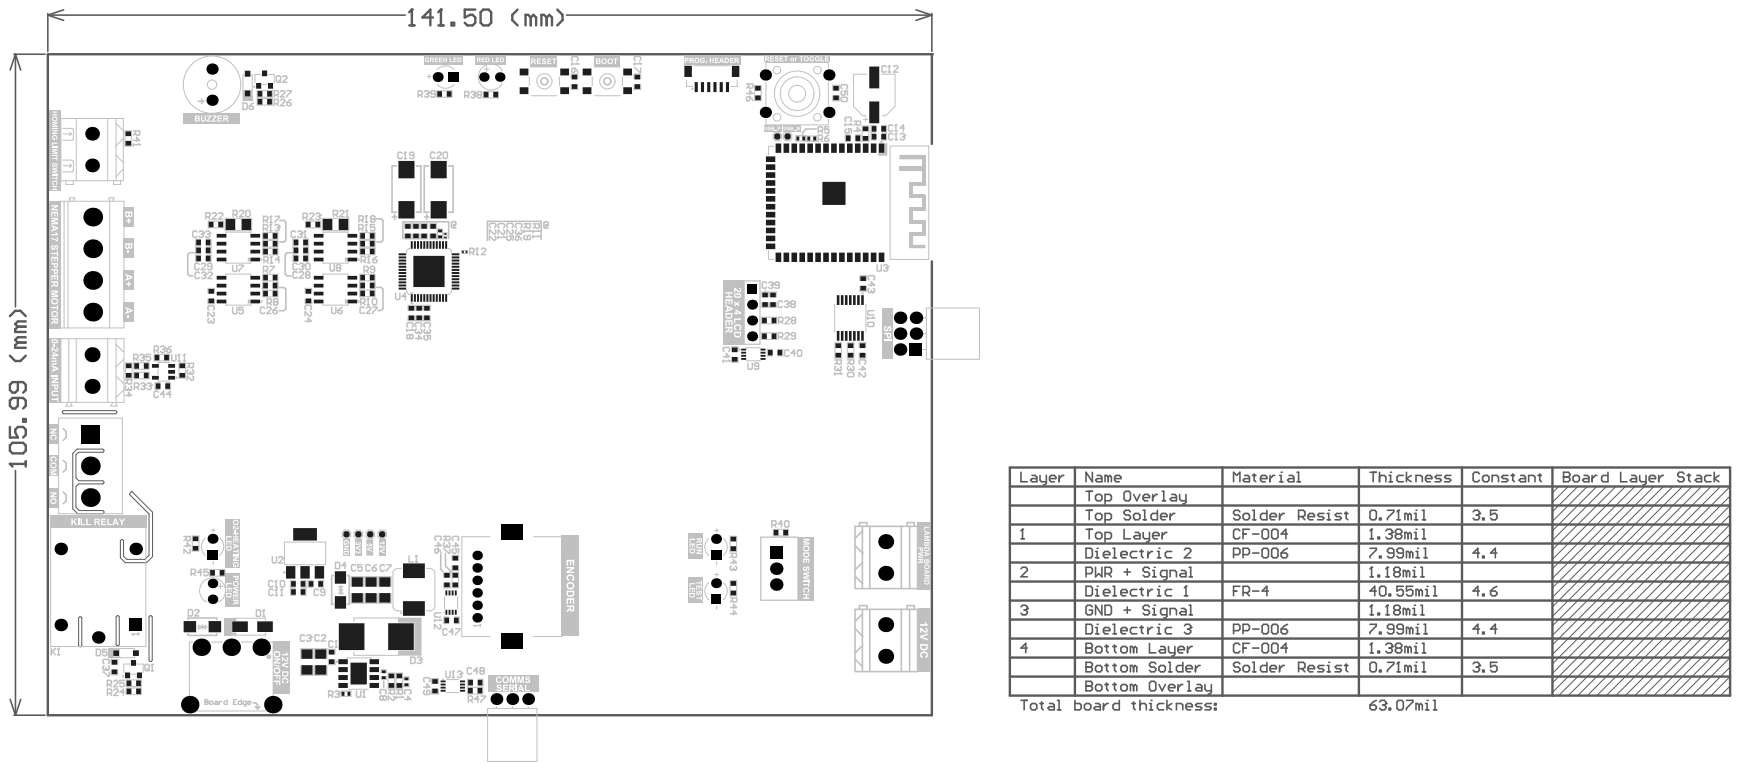
[picture p30: page 1]

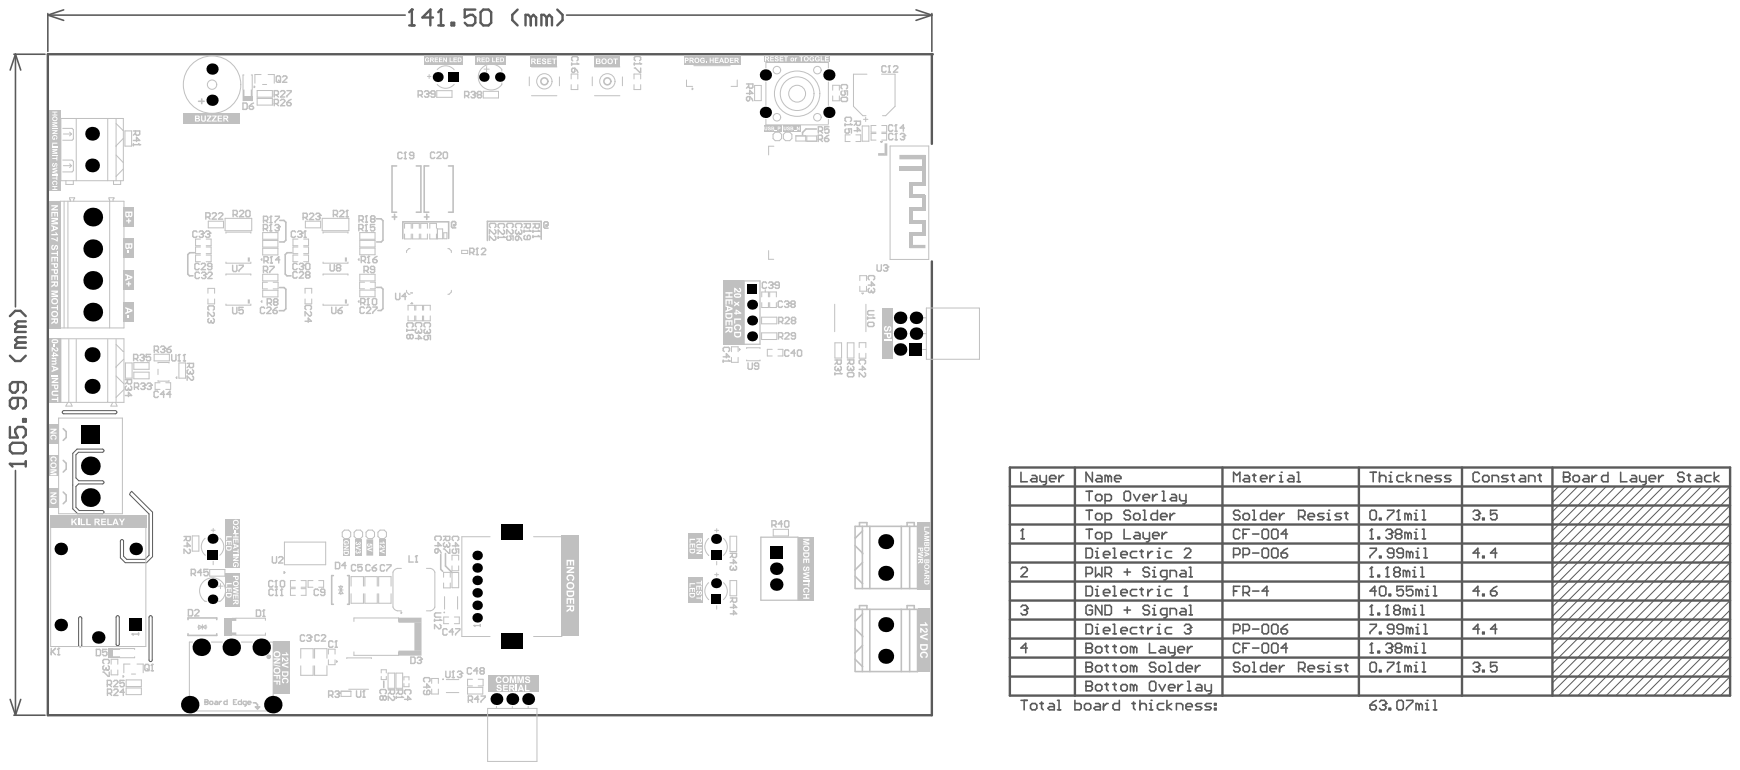
[picture p31: page 2]

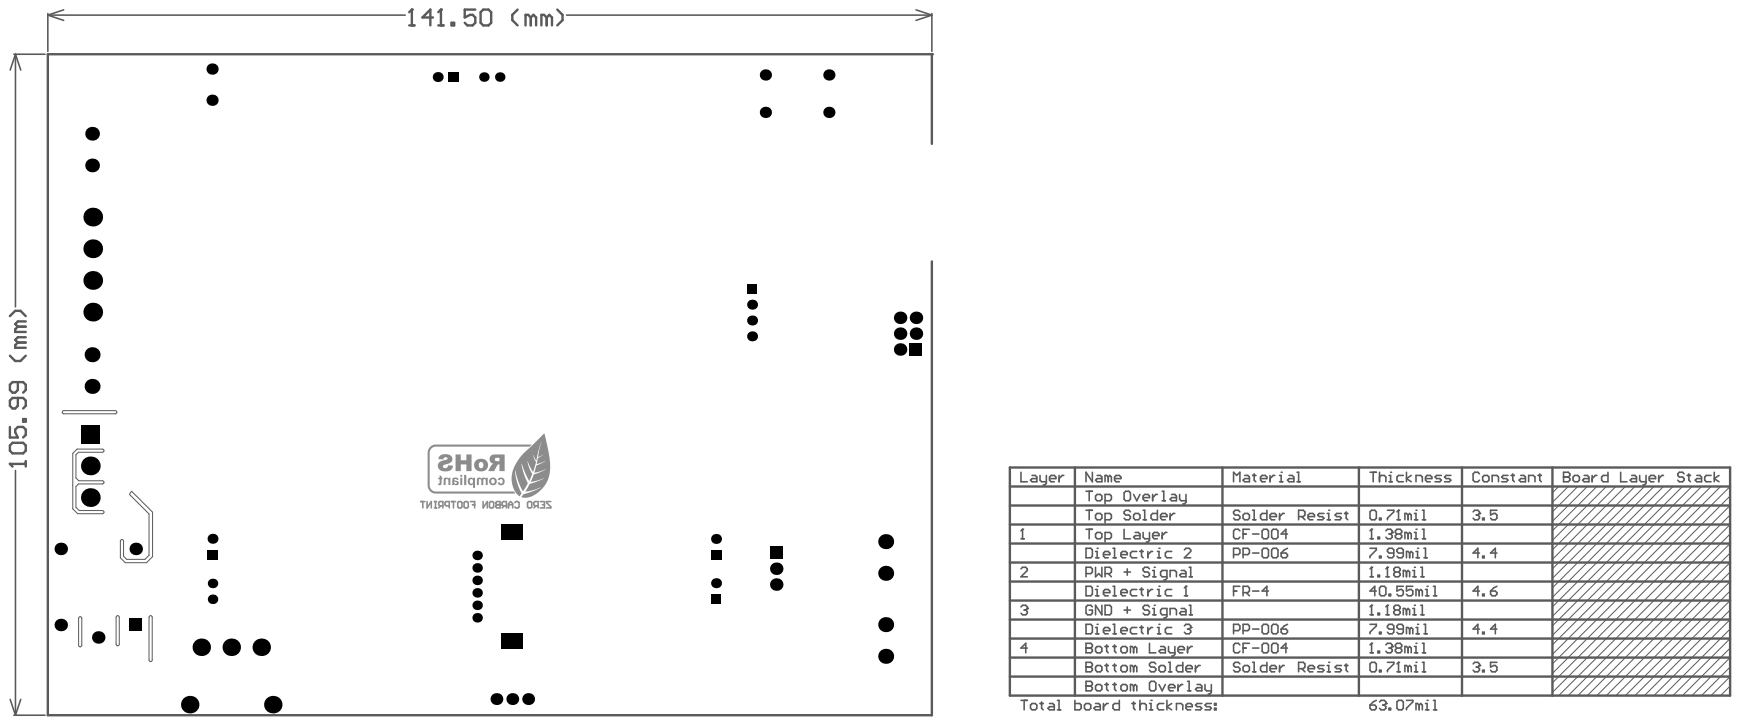
[picture p32: page 3]
