eSpark-Backup/noelmcdermott-dbsdesign-hw/Design-Files/DBS-Stepper-Module/Renderings/PCB_DBS_Module-v1.0-Latest.pdf

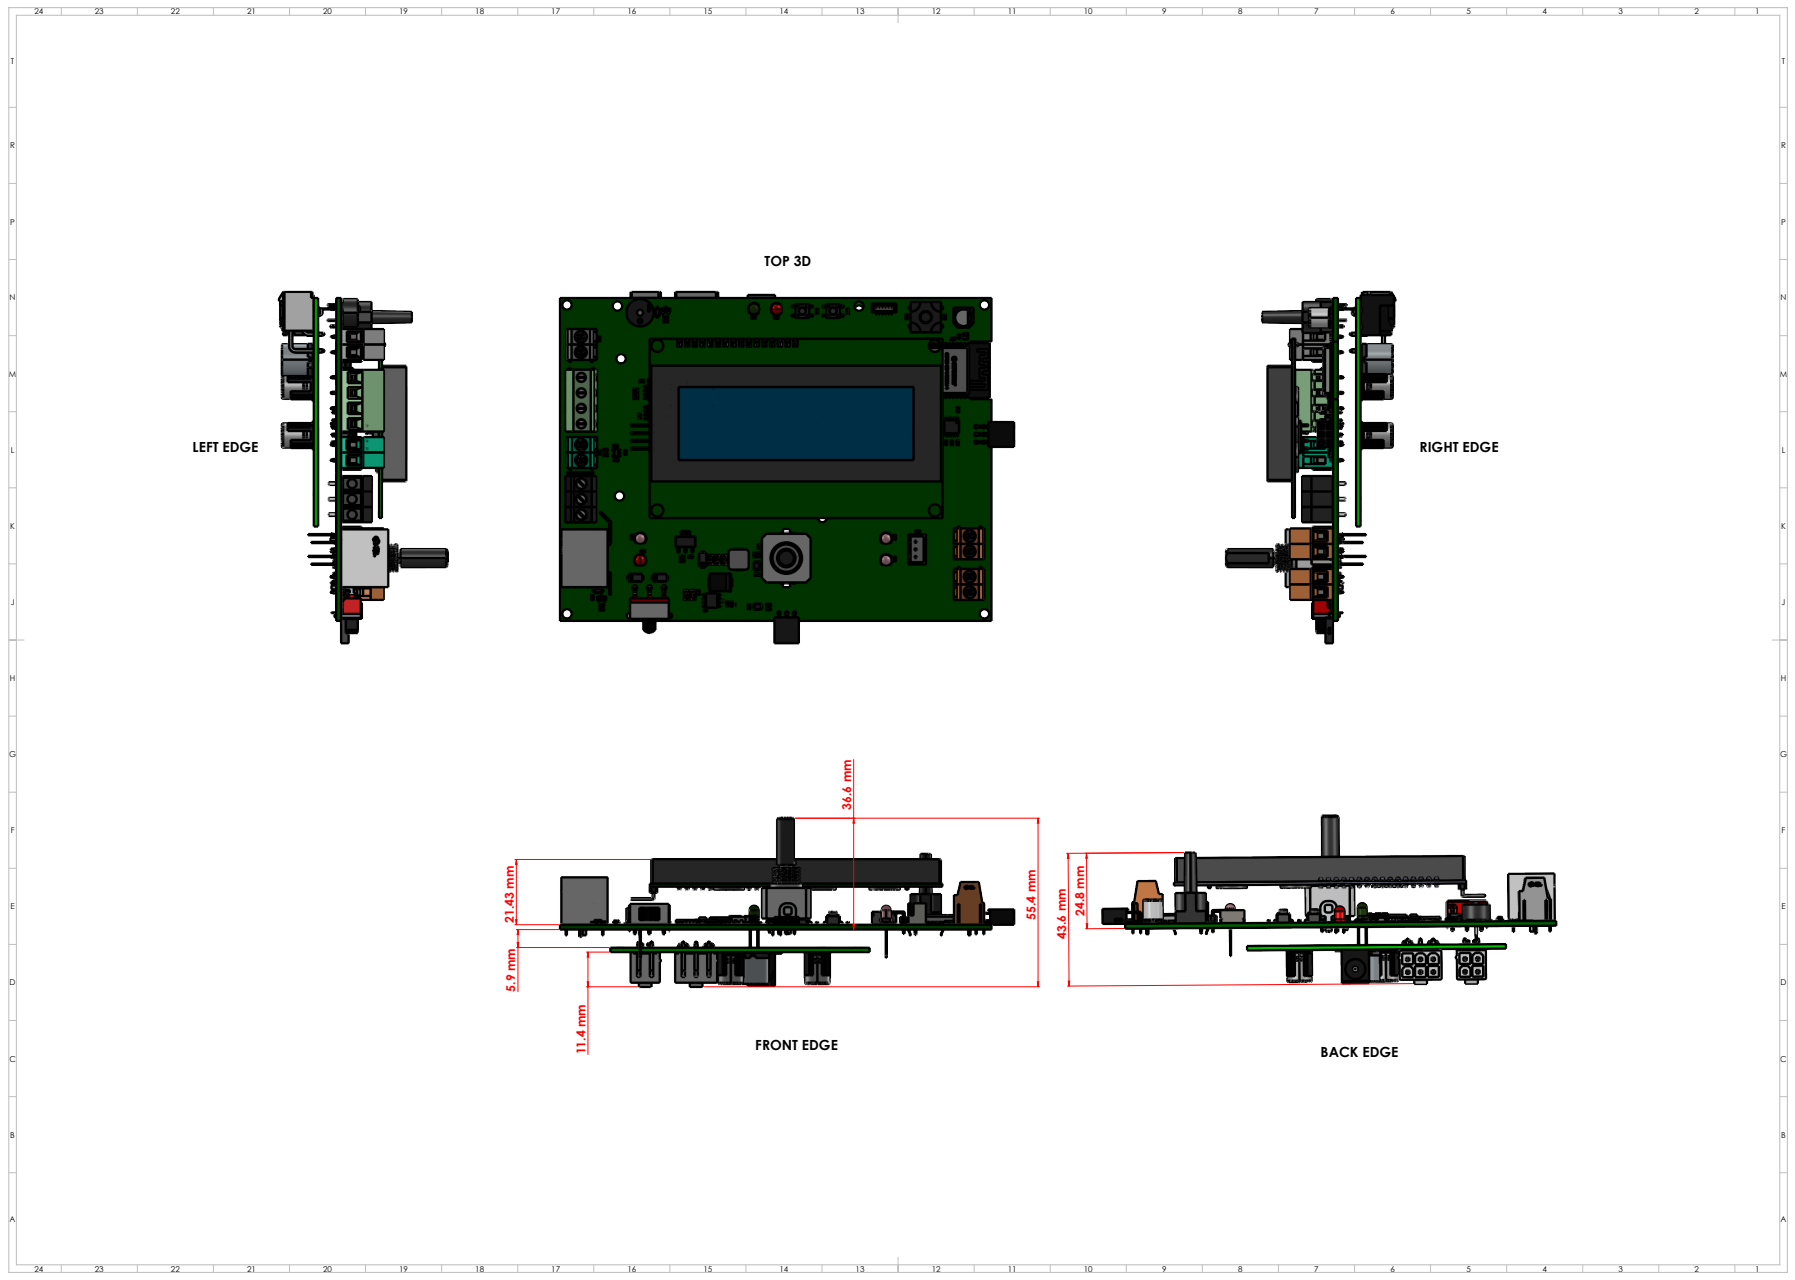
[picture p33: page 1]
TOP 3D; RIGHT EDGE; FRONT EDGE; BACK EDGE; LEFT EDGE
