eSpark-Backup/noelmcdermott-dbsdesign-hw/(list of files, drawings)

Other design files:
Design-Files/DBS-Stepper-Module/0-24mA-Input-Sheet.SchDoc
Design-Files/DBS-Stepper-Module/01M21V00-Sensor-Sheet.SchDoc
Design-Files/DBS-Stepper-Module/20x4-Display-Sheet.SchDoc
Design-Files/DBS-Stepper-Module/Buzzer-Sheet.SchDoc
Design-Files/DBS-Stepper-Module/Connectors-SW-LEDs-Sheet.SchDoc
Design-Files/DBS-Stepper-Module/Controller-Sheet.SchDoc
Design-Files/DBS-Stepper-Module/DBS-Stepper-Module-v1.0.PrjPcb
Design-Files/DBS-Stepper-Module/DBS-Stepper-Module.PrjPcb
Design-Files/DBS-Stepper-Module/Optical-Encoder-Sheet.SchDoc
Design-Files/DBS-Stepper-Module/PCB_DBS_Module-v1.0.PcbDoc
Design-Files/DBS-Stepper-Module/Power-Sheet.SchDoc
Design-Files/DBS-Stepper-Module/Relay-Sheet.SchDoc
Design-Files/DBS-Stepper-Module/Stepper-Driver-Sheet.SchDoc
Design-Files/DBS-Stepper-Module/Top-Sheet.SchDoc
