eSpark-Backup/noelmcdermott-dbsdesign-hw/(commit log)

2024-06-27 Multiple Sheets added
    [01M21V00-Sensor-Sheet.SchDoc, Buzzer-Sheet.SchDoc, Connector-Sheet.SchDoc, Controller-Sheet.SchDoc, DBS-Stepper-Module.PrjPcb, Power-Sheet.SchDoc, Relay-Sheet.SchDoc, Stepper-Driver-Sheet.SchDoc]
2024-06-28 #1 Multiple Sheets added.
    [0-24mA-Input-Sheet.SchDoc, 01M21V00-Sensor-Sheet.SchDoc, 20x4-Display-Sheet.SchDoc, Buzzer-Sheet.SchDoc, Connector-Sheet.SchDoc, Connectors-SW-LEDs-Sheet.SchDoc, Controller-Sheet.SchDoc, DBS-Stepper-Module.PrjPcb]
2024-06-28 #1 Complete. Top Sheet remaining. PDF Generated
    [0-24mA-Input-Sheet.SchDoc, 01M21V00-Sensor-Sheet.SchDoc, 20x4-Display-Sheet.SchDoc, Buzzer-Sheet.SchDoc, Connectors-SW-LEDs-Sheet.SchDoc, Controller-Sheet.SchDoc, DBS-Stepper-Module.PrjPcb, Optical-Encoder-Sheet.SchDoc]
2024-07-02 #2 Placement In-progress.
    [0-24mA-Input-Sheet.SchDoc, 01M21V00-Sensor-Sheet.SchDoc, Controller-Sheet.SchDoc, DBS-Stepper-Module-v1.0.PrjPcb, PCB_DBS_Module-v1.0.PcbDoc, Relay-Sheet.SchDoc]
2024-07-03 #3 Client BOM Updated.
    [Client_BOM with Price.xlsx]
2024-07-03 #3 Peripheral added
    [Client_BOM with Price.xlsx]
2024-07-03 #1 #3 Ports and Harnesses added. J8 and J6 changed.
    [0-24mA-Input-Sheet.SchDoc, 01M21V00-Sensor-Sheet.SchDoc, 20x4-Display-Sheet.SchDoc, Buzzer-Sheet.SchDoc, Connectors-SW-LEDs-Sheet.SchDoc, Controller-Sheet.SchDoc, DBS-Stepper-Module-v1.0.PrjPcb, Optical-Encoder-Sheet.SchDoc]
2024-07-04 Formatting in Client BOM
    [Client-BOM-v1.0.xlsx, eSpark-BOM-v1.0.xlsx]
2024-07-04 10 board costs removed from client BOM #3
    [Client-BOM-v1.0.xlsx]
2024-07-04 #1 Top Sheet added. PDF Updated
    [Connectors-SW-LEDs-Sheet.SchDoc, Controller-Sheet.SchDoc, DBS-Stepper-Module-v1.0.PrjPcb, Top-Sheet.SchDoc]
2024-07-04 #2 Routing In-progress.
    [20x4-Display-Sheet.SchDoc, DBS-Stepper-Module-v1.0.PrjPcb, PCB_DBS_Module-v1.0.PcbDoc, Top-Sheet.SchDoc]
2024-07-06 New Renderings added: Changes in PCB in-progress.
    [PCB_DBS_Module-v1.0.PcbDoc]
2024-07-06 Rendering Updated.
    [PCB_DBS_Module-v1.0.PcbDoc]
2024-07-08 #2 Routing In-progress. Renderings updated.
    [DBS-Stepper-Module-v1.0.PrjPcb, PCB_DBS_Module-v1.0.PcbDoc]
2024-07-09 #2 Male Headers replaced. Lambda Board added: Routing In-progress.
    [01M21V00-Sensor-Sheet.SchDoc, Connectors-SW-LEDs-Sheet.SchDoc, PCB_DBS_Module-v1.0.PcbDoc]
2024-07-10 #1 #2 DC jack removed. Two terminal blocks for power added.
    [0-24mA-Input-Sheet.SchDoc, Connectors-SW-LEDs-Sheet.SchDoc]
2024-07-10 #2 Renderings Updated: Routing In-progress.
    [0-24mA-Input-Sheet.SchDoc, Connectors-SW-LEDs-Sheet.SchDoc, PCB_DBS_Module-v1.0.PcbDoc]
2024-07-11 #1 SW5 and SW6 changed to 17.5mm height switches.
    [Connectors-SW-LEDs-Sheet.SchDoc]
2024-07-11 #2 PCB Size increased: Routing In-progress.
    [0-24mA-Input-Sheet.SchDoc, 01M21V00-Sensor-Sheet.SchDoc, 20x4-Display-Sheet.SchDoc, Buzzer-Sheet.SchDoc, Connectors-SW-LEDs-Sheet.SchDoc, Controller-Sheet.SchDoc, Optical-Encoder-Sheet.SchDoc, PCB_DBS_Module-v1.0.PcbDoc]
2024-07-12 #1 C19 and C20 changed
    [Stepper-Driver-Sheet.SchDoc]
2024-07-12 #1 Changes done in Schematic for CS pin. Fresh PDF generated.
    [01M21V00-Sensor-Sheet.SchDoc, DBS-Stepper-Module-v1.0.PrjPcb]
2024-07-18 #1 switch changed headers added
    [Connectors-SW-LEDs-Sheet.SchDoc]
2024-07-18 #2 Routing completed: Finishing Remaining.
    [Connectors-SW-LEDs-Sheet.SchDoc, DBS-Stepper-Module-v1.0.PrjPcb, PCB_DBS_Module-v1.0.PcbDoc, Stepper-Driver-Sheet.SchDoc]
2024-07-19 #2 PCB Completed: Fresh Altium BOM generated:
    [DBS-Stepper-Module-v1.0.PrjPcb, PCB_DBS_Module-v1.0.PcbDoc]
2024-07-19 #2 Fresh Deliverables created: Fresh Altium BOM Generated and Peripherals added.
    [0-24mA-Input-Sheet.SchDoc, 01M21V00-Sensor-Sheet.SchDoc, 20x4-Display-Sheet.SchDoc, Altium_BOM-Latest-v1.0.xlsx, Buzzer-Sheet.SchDoc, Centroid_File-v1.0.csv, Connectors-SW-LEDs-Sheet.SchDoc, Controller-Sheet.SchDoc]
2024-07-20 #2 Fresh Deliverables generated.
    [0-24mA-Input-Sheet.SchDoc, 01M21V00-Sensor-Sheet.SchDoc, 20x4-Display-Sheet.SchDoc, Altium_BOM-Latest-v1.0.xlsx, Buzzer-Sheet.SchDoc, Centroid_File-v1.0.csv, Connectors-SW-LEDs-Sheet.SchDoc, Controller-Sheet.SchDoc]
2024-07-23 #3 Client BOM update.
    [Client Files.xlsx, Client-BOM-v1.0.xlsx, eSpark-BOM-v1.0.xlsx]
2024-07-23 #3 Updated Client BOM.
    [Client BOM.xlsx]
2024-08-05 Client actual ordered quantities added to BOM #3
    [Client BOM.xlsx]
2024-10-04 #2 Fresh Gerber and NC Drill Files generated.
    [DBS-Stepper-Module-v1.0.PrjPcb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]
2024-11-28 #3 Peripheral Link add in Client BOM.
    [Altium_BOM-Latest-v1.0.xlsx, Client BOM-v1.0.xlsx, Client BOM.xlsx]
